jbaumann/attiny_daemon/hardware/breadboard/Breadboard.JPG

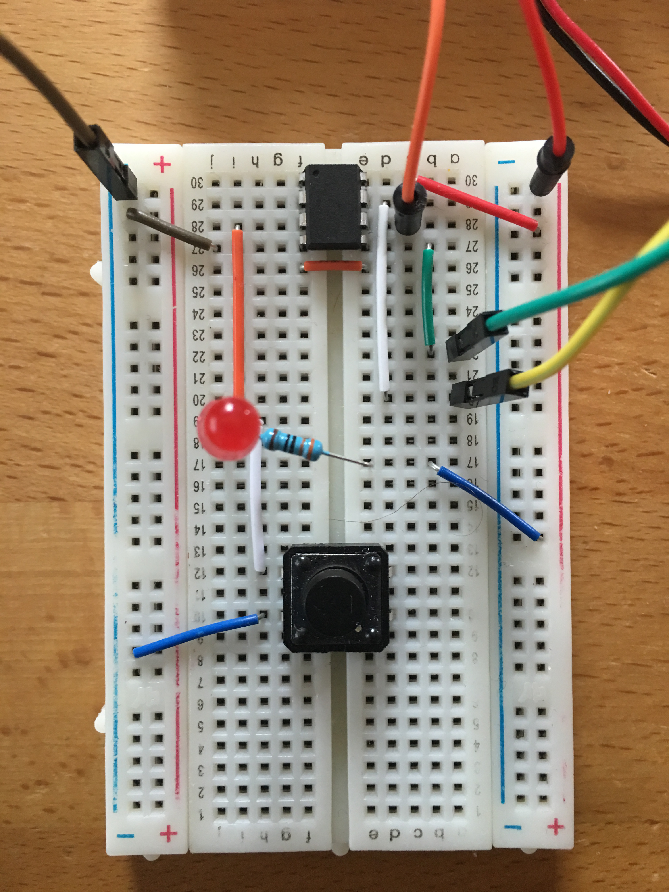
hardware/breadboard/Breadboard.JPG
