jbaumann/attiny_daemon/hardware/breadboard/Breadboard_Raspberry.JPG

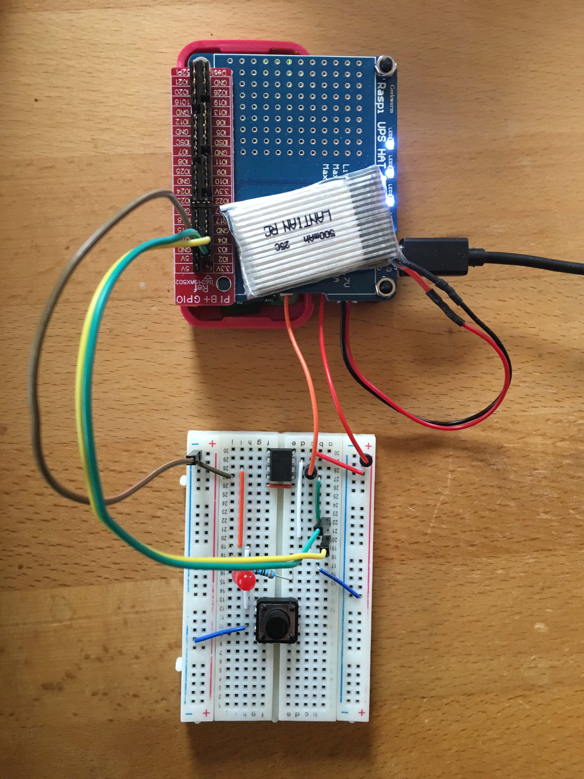
hardware/breadboard/Breadboard_Raspberry.JPG
