jbaumann/attiny_daemon/hardware/v1.8/PCB.png

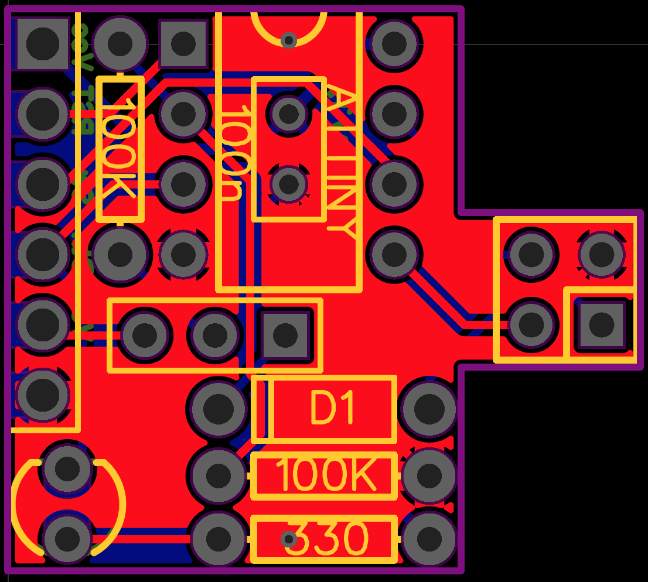
hardware/v1.8/PCB.png
