jbaumann/attiny_daemon/hardware/v1.8/Photo_Bottom_View.png

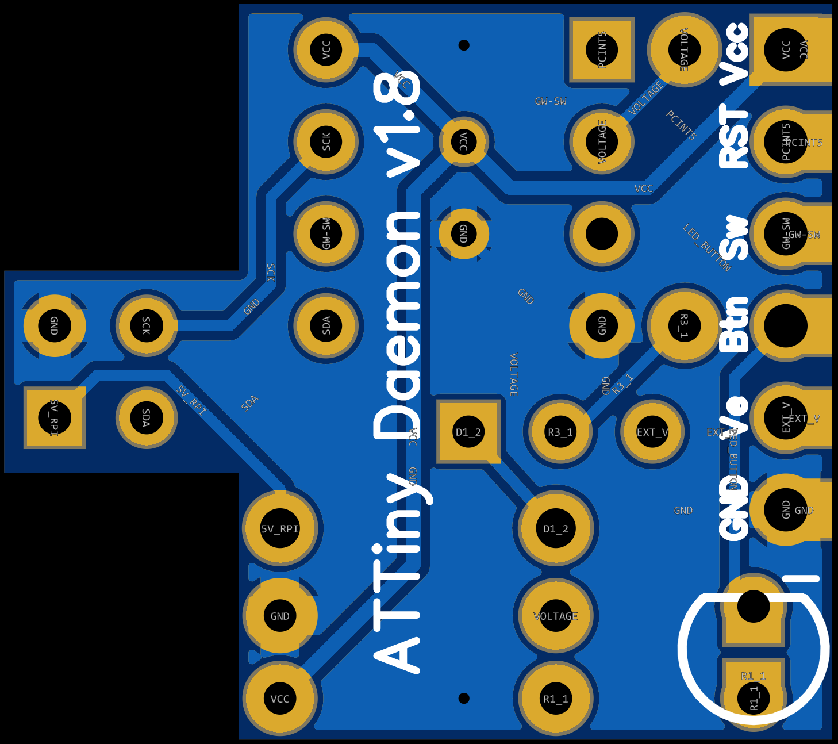
hardware/v1.8/Photo_Bottom_View.png
