jbaumann/attiny_daemon/hardware/v1.8/Schematic_ATTinyDaemon.png

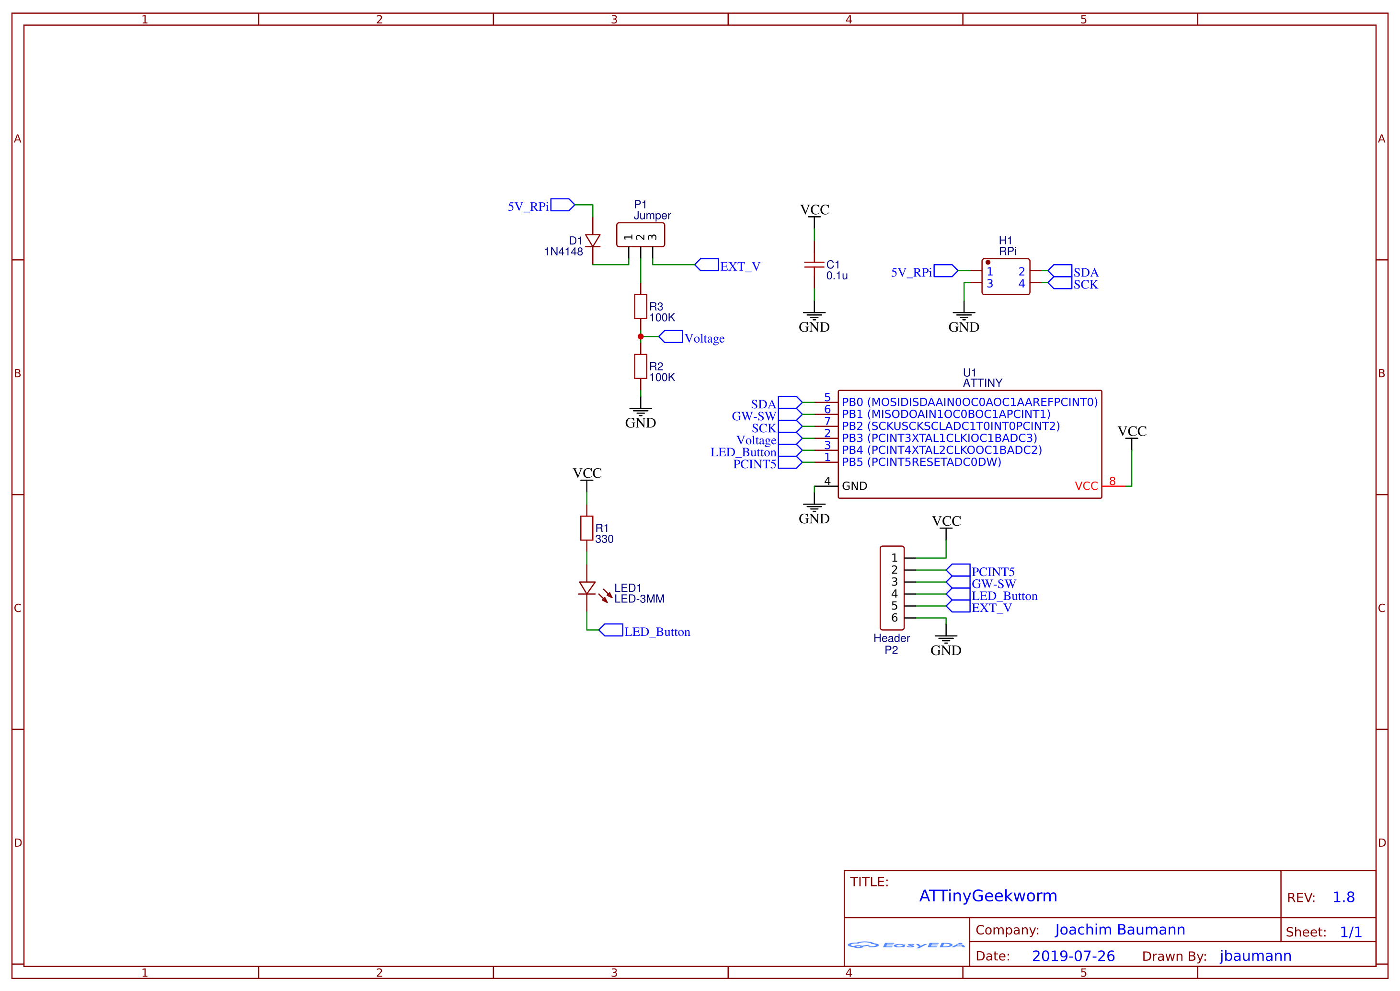
hardware/v1.8/Schematic_ATTinyDaemon.png
