jbaumann/attiny_daemon/hardware/v1.8/Schematic_ATTinyDaemon_cropped.png

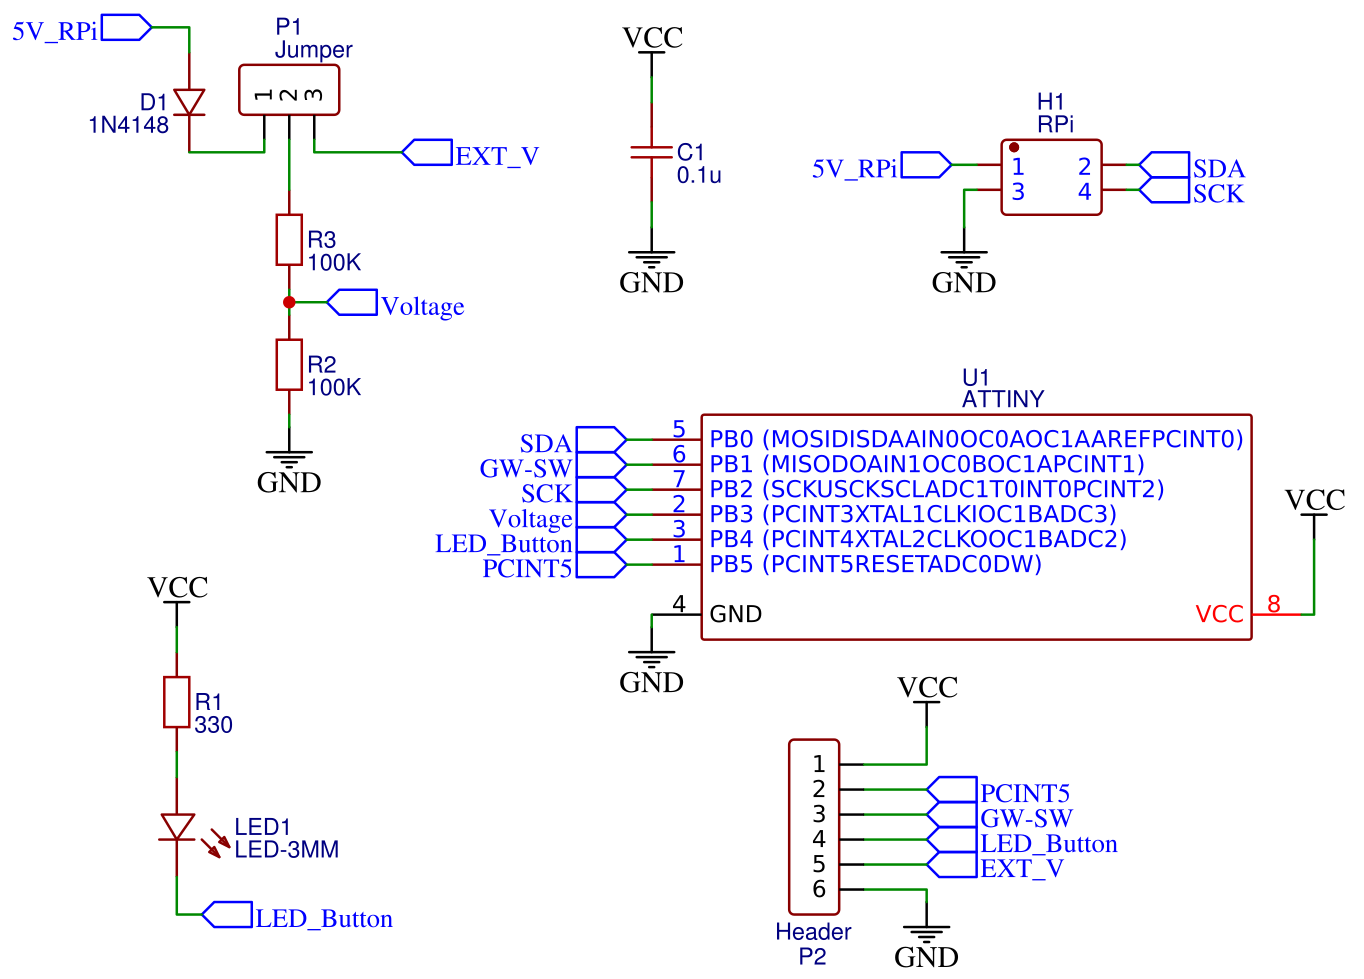
hardware/v1.8/Schematic_ATTinyDaemon_cropped.png
