jbaumann/attiny_daemon/hardware/v1.8shim/PCB.png

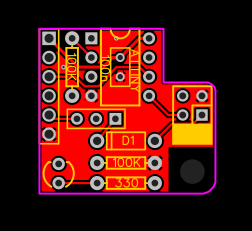
hardware/v1.8shim/PCB.png
