jbaumann/attiny_daemon/hardware/v1.8shim/Photo_Bottom_View.png

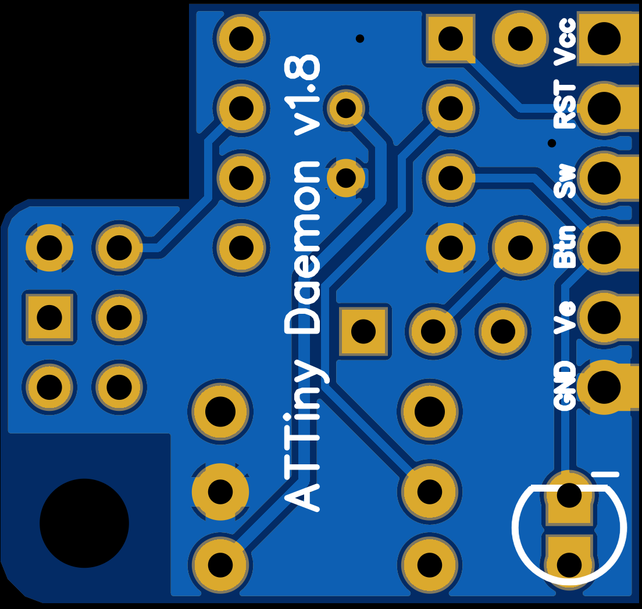
hardware/v1.8shim/Photo_Bottom_View.png
