jbaumann/attiny_daemon/hardware/v1.8shim/ATTiny1.8_installed_on_GW_UPS1.jpeg

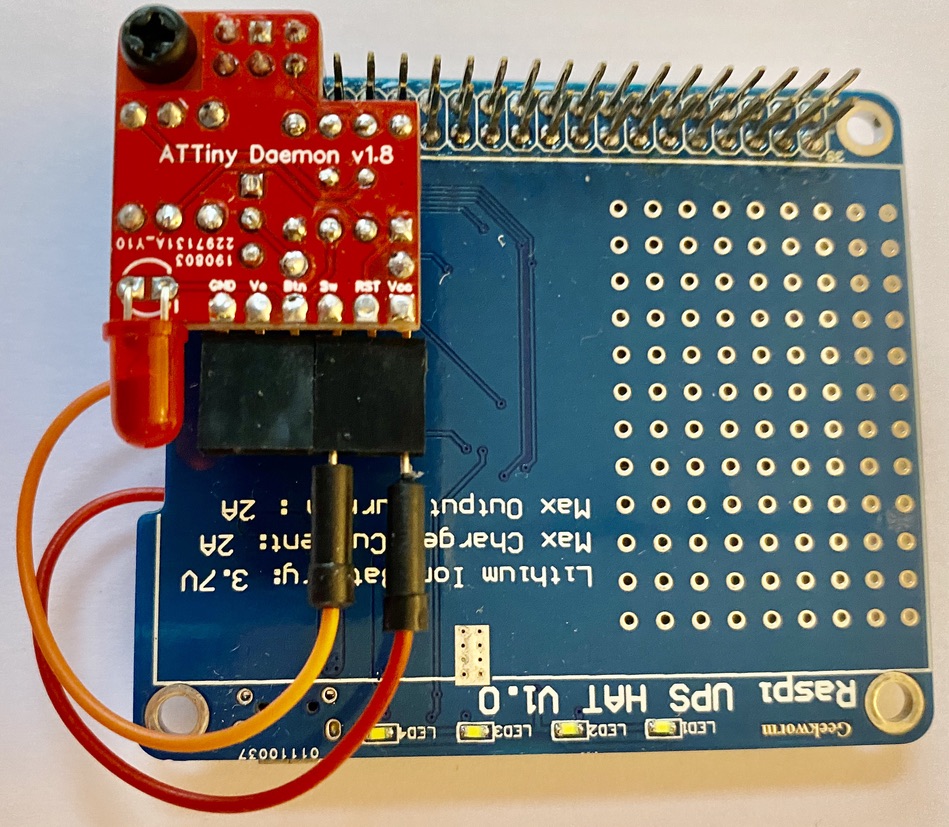
hardware/v1.8shim/ATTiny1.8_installed_on_GW_UPS1.jpeg
