jbaumann/attiny_daemon/(threads)

Thread 1 (2019-08-31):

Multiple-Cell Batteries...

starhawk64, 2019-08-31:
Apologies for contacting you here, but I can find NO other way to get ahold of you (please create or otherwise expose a public-facing email address! It would be very helpful.).

I want to implement this device, using a USB power bank "kit" (a plastic housing and the power bank controller PCB, with room for up to six 18650 cells) and some 18650 cells from old laptop batteries. HOWEVER, I can't tell how to interface / monitor multiple batteries at once, and I'd be concerned about the batteries' respective charges getting out of whack -- I don't know much about LiPoly cells, but I know they have a nasty temper and I know that balancing cells is a concern. (...and, yes, I also know better than to solder to batteries. While I've not read up on the latest LiPoly concerns, I'm mildly experienced as an electronics hobbyist.)

Example listing for power bank kit (mine is identical, but not from that listing) --> https://www.ebay.com/itm/183897827870

jbaumann, 2019-09-03:
Sorry for not exposing the e-mail address, should work now.

To me it seems that the kit is doing all the balancing so that should be taken care of, as far as I can see. However, you would need to connect the Vcc of the ATTiny_Daemon to the balanced output of the batteries inside the power bank. Do you have a schematic of the power bank you want to use?

starhawk64, 2019-09-03:
I don;t need schematics in this case -- it's a "bring your own batteries"
kit. I thought I was more clear about that, sorry...

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

jbaumann, 2019-09-03:
Ok, let us assume that the batteries are balanced by your power bank, for charging and discharging. Then each one of the batteries should have roughly the same charge and thus roughly the same voltage. So simply solder one wire to the positive terminal of the battery holder for one of the batteries and then use that as Vcc for the ATTiny_Daemon (assuming that GND is connected to the negative terminal). Since the current needed by the ATTiny_Daemon is very small compared to the needs of the RPi this shouldn't unbalance the batteries unduly.

starhawk64, 2019-09-03:
OK, great! Thanks :) I'm really looking forward to making this...

One other question... how long can the I2C wires be? What I'm building
requires a short distance there. I was thinking of using optocouplers to
make an I2C-to-current loop adapter (since current loops can go for truly
insane lengths of distance when they have to) but I don't; want to rig that
if I don't have to. I think I can keep it to less than six or eight inches.

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

jbaumann, 2019-09-03:
I'm using normal Dupont wires with 20cm length quite often when experimenting with I2C. This should be around 8in. Since I used a CRC to check the correctness of the transferred data and a simple retransmit in case of errors this should work with even longer cables without problems (I think that 1m is given as a maximum quite often...).

starhawk64, 2019-09-03:
Okay, awesome! Thanks for the help :)

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

jbaumann, 2019-09-05:
Only to be sure: Check that GND and the negative terminal of the battery are connected. Otherwise it is not that simple... And let me know how it goes.

Closed 2020-03-23.

Thread 2 (2019-09-17):

Connections

st599, 2019-09-17:
Hi

I can't see from your documentation where the wires from the modified board are connected to or where exactly the Dupont connector attaches.

Could you provide images of the final layout?

jbaumann, 2019-09-20:
Thank you for the feedback, I will write an additional Wiki entry as soon as I have time.

If you look at the layout from the bottom side, I have labelled the different connections.  Here is a link to the picture: https://github.com/jbaumann/attiny_daemon/blob/master/hardware/v1.8shim/Photo_Bottom_View.png

If you look at this description of the board modification: https://github.com/jbaumann/attiny_daemon/wiki/Modifying-the-Geekworm-UPS-HAT

you connect the red cable (soldered to the battery power) to _Vcc_ (the connection on the right in the picture of the board) and the orange cable (soldered to the switch connection) to the pin labeled _Sw_ (the third from the right on the picture.

If you want to connect a button you simple connect it to Btn and GND, and if you want to measure an additional external voltage you connect it to Ve.

Does this help until I write the documentation?

adrianmihalko, 2019-12-16:
@jbaumann thanks for this great project. I aggree that the Wiki is covering many thing, but it's a little bit unclear to me. There should be a single page with

- modification of the Pi, needed to install the PCB
- complete assembly of the PCB and it's installation on the Pi
- Software installation

Anyone has one or two PCB free available in the EU? If I order now, I need to wait 1 month from china. :(

jbaumann, 2019-12-18:
Adrian, thank you for your praise and your suggestion. I‘m not sure whether a single page with all the information is better than multiple pages, but I can try and write a step-by-step guide that references the other pages that I have already written.

The Pi does not need any modification, which was in fact one of my goals when creating the project. The UPS has to be modified though.
The assembly of the PCB is extremely simple and the silk screen printed on the PCB even gives the values for every component, so this shouldn‘t be a problem, but I‘ll look into writing something up with a few pictures (e.g., components with a low height first, how to bend the connector and the LED etc.).
One question, though, without being disrespectful: If someone is able to follow the instructions to modify the UPS, shouldn‘t they also be able to assemble the board?

The software installation is already described in detail in this page: https://github.com/jbaumann/attiny_daemon/wiki/Installation-on-the-Raspberry-Pi

My experience with JLCPCB (I‘m not affiliated with them in any way) is very good and so far I have received the PCBs I ordered in 2 weeks (more or less). So it is not as bad as you think, but you won‘t be receiving the PCBs before Christmas.

jbaumann, 2020-01-06:
I have now described the assembly of the board in details, please have a look: https://github.com/jbaumann/attiny_daemon/wiki/Assembling-the-ATTiny_Daemon-Hardware

jbaumann, 2020-01-06:
I have described the connections to the board in detail on the following page: https://github.com/jbaumann/attiny_daemon/wiki/Connecting-the-ATTiny_Daemon-Hardware

Please have a look

adrianmihalko, 2020-01-08:
Wow, it's way more clear now. Thanks for the update, parts ordered.

Closed 2020-03-23.

Thread 3 (2019-10-12):

Support for Geekworm's new UPS HAT2?

poky, 2019-10-12:
It appears Geekworm has released their RPi4B supported UPS HAT

https://geekworm.com/products/raspberry-pi-ups-hat-2

It also mentioned the I2C power off function, does anyone on here have tried?

jbaumann, 2019-10-12:
It sounds pretty interesting, and if it works as promised then we might be able to use it with ATTiny_Daemon directly, without the hardware modification.

I haven’t read about an I2C power-off feature, only the auto-power-on. Was it this feature you meant?

I have contacted Geekworm and asked for further information (chips, schematics, etc.). If it sounds ok I will order (at least) one to test it...

jbaumann, 2019-10-12:
And already got an answer. They “cannot” provide any information. I looked at the photo of the UPS2, and I cannot read anything on the chips, but they also have a Github repo for it https://github.com/geekworm-com/UPS2. They use a power-off dtoverlay.

jbaumann, 2019-10-12:
I have been offered a sample to experiment with, looking forward to test it.

akula3, 2019-12-03:
Hello Joachim!
I'm looking for an UPS with the same features like you.
Your project is very interesting, but I wouldn't trust me to solder on SMD's.
Did you make already some positive experience with the UPS HAT2 from geekworm and can share that?
Danke schön :-)

jbaumann, 2019-12-11:
I have now done the first tests and the preliminary conclusion is that it might be usable as an UPS. It will need the ATTinyDaemon to work properly though.
Caveats: The charge amperage should be changed from 2A (default setting) to 1A. To do this a solder bridge has to be removed and another one soldered on two pads. This shouldn't be a problem even for beginners.
I would also enable the additional signalling that the RPi has shut down, and this needs another solder bridge.
Detailed information will follow in a few weeks...

And akula3, you should never try to charge a LiPo battery using a Li-Ion charging circuit.

jbaumann, 2020-03-29:
I just created a new release that supports the Geekworm UPS2. I currently use it successfully and can recommend it. One modification is necessary though. You should change the maximum charge current to 1A, otherwise the output voltage will dip for a short time sometimes leading to crashes. And you really need to use a battery with at least 2.500mAh (to provide the maximum needed amperag).
I will try and find the time to write up a review and how to install everything (much simpler than with the Geekworm UPS 1, you only need to solder a cable to the switch itself and one to the battery pad with the positive voltage).

jbaumann, 2020-04-11:
It took some time to write it up but you can find the short review and the needed modifications in the Wiki.

Closed 2020-04-11.

Thread 4 (2020-02-06):

Help needed

rahmanshaber, 2020-02-06:
Hi, I am developing a portable pi UMPC/sidekick. I want to add your solution there and forget about developing one from ground.
So i need Help of yours to get things right.
1. i will use a existing battery charging breakout board to charge the battery. [this one](https://www.aliexpress.com/item/32798858483.html)
2. so can i use the the ups part form your project to power off the system from raspberry pi and a button to boot the pi?
3. i want to see the battery details in with regular way like you can see the laptop battery details in app like xfce-battery or lxqt-battery plugin for panel . Or a terminal way is ok.

Please help me out
Here is my project.
https://mutantc.gitlab.io/

jbaumann, 2020-02-14:
Hi,

I‘m sorry for the delay in answering your e-Mail. I‘m currently on vacation and will look into it after I‘m back. Without looking into the details most of what you need should be possible. Starting the Pi using abutting might be a bit more complicated but let me think about that when I‘m back.

Cheers, Joachim
Am 6. Feb. 2020, 07:46 +0200 schrieb rahmanshaber <notifications@github.com>:
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

rahmanshaber, 2020-02-16:
thanks. I am waiting.

jbaumann, 2020-03-23:
The button should work as you need it (it was already implemented), and the data can be read using the Python class Attiny_i2c. Its use is shown in the script useATTiny.py. You can use this to display the needed information however you want it.

Closed 2020-03-23.

Thread 5 (2020-02-15):

Couldn't read 16 bit register 0x1 correctly.

BaiGeorgi, 2020-02-15:
When i run "sudo systemctl status attiny_daemon" i get this error:

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

Can you tell me what is wrong?

jbaumann, 2020-02-15:
I‘m currently on vacation, but this means that not all read requests have been successful (which is quite normal and no problem) and that you have the debug flag still enabled in your configuration. As long as you only get the debug message and no warning everything is ok.
If you do not want to see these messages simply turn debug messages off as soon as you have verified that everything works ok.

BaiGeorgi, 2020-02-15:
Thank you for the information.

Closed 2020-02-15.

Thread 7 (2020-02-24):

USIWire issue?

pawsnizzy, 2020-02-24:
Hi,
I am intent on implementing this device on my RPi, but am getting the following errors in the Arduino IDE:

`In file included from C:\Users\Dave\Documents\Arduino\libraries\USIWire\src\USI_TWI_Master/USI_TWI_Master.h:76:0,

                 from C:\Users\Dave\Documents\Arduino\libraries\USIWire\src\USIWire.cpp:27:

C:\Users\Dave\Documents\Arduino\libraries\USIWire\src\USI_TWI_Master/usi_io.h:1:1: error: expected unqualified-id before '.' token

 ../USI_TWI_Slave/usi_io.h

 ^

C:\Users\Dave\Documents\Arduino\libraries\USIWire\src\USIWire.cpp: In member function 'void USIWire::begin()':

C:\Users\Dave\Documents\Arduino\libraries\USIWire\src\USIWire.cpp:55:3: error: 'USI_TWI_Master_Initialise' was not declared in this scope

   USI_TWI_Master_Initialise();

   ^~~~~~~~~~~~~~~~~~~~~~~~~

C:\Users\Dave\Documents\Arduino\libraries\USIWire\src\USIWire.cpp:55:3: note: suggested alternative: 'USI_TWI_Slave_Initialise'

   USI_TWI_Master_Initialise();

   ^~~~~~~~~~~~~~~~~~~~~~~~~

   USI_TWI_Slave_Initialise

Multiple libraries were found for "USIWire.h"
 Used: C:\Users\Dave\Documents\Arduino\libraries\USIWire
Multiple libraries were found for "EEPROM.h"
 Used: C:\Program
exit status 1
Error compiling for board ATtiny25/45/85.
`
Can you suggest where I went wrong - these error messages might as well be in greek:(

Thanks

jbaumann, 2020-02-25:
Hi,

To me this looks like multiple libraries/library versions for the USIWire implementation in your library path. Could you check and verify that you have only one library version (and preferably the one that I used i.e., 0.1.0)?

The same seems to have happened with your eeprom library...

Cheers, Joachim
Am 24. Feb. 2020, 21:25 +0100 schrieb pawsnizzy <notifications@github.com>:
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

pawsnizzy, 2020-03-15:
No multople libaries at all - I've even gone so far as to delete EVERY library except the 2 above - and it's still the same

adrianmihalko, 2020-03-21:
I have same problem. Arduino 1.8.12. Without Usiwire library I get error about missing library (as expected)

```
In file included from /Users/adrianmihalko/Downloads/attiny_daemon-master/firmware/ATTinyDaemon/ATTinyDaemon.ino:1:0:
ATTinyDaemon.h:1:10: fatal error: USIWire.h: No such file or directory
 #include <USIWire.h>
          ^~~~~~~~~~~
compilation terminated.
exit status 1
USIWire.h: No such file or directory
```

Now, I install library as Sketch - Include Library - Add .ZIP Library and I choose USIWire-0.1.0.zip.

I click Very/Compile and I get the same error:

```
In file included from /Users/adrianmihalko/Documents/Arduino/libraries/USIWire-0.1.0/src/USI_TWI_Master/USI_TWI_Master.h:76:0,
                 from /Users/adrianmihalko/Documents/Arduino/libraries/USIWire-0.1.0/src/USIWire.cpp:27:
/Users/adrianmihalko/Documents/Arduino/libraries/USIWire-0.1.0/src/USI_TWI_Master/usi_io.h:1:1: error: expected unqualified-id before '.' token
 ../USI_TWI_Slave/usi_io.h
 ^
/Users/adrianmihalko/Documents/Arduino/libraries/USIWire-0.1.0/src/USIWire.cpp: In member function 'void USIWire::begin()':
/Users/adrianmihalko/Documents/Arduino/libraries/USIWire-0.1.0/src/USIWire.cpp:55:3: error: 'USI_TWI_Master_Initialise' was not declared in this scope
   USI_TWI_Master_Initialise();
   ^~~~~~~~~~~~~~~~~~~~~~~~~
/Users/adrianmihalko/Documents/Arduino/libraries/USIWire-0.1.0/src/USIWire.cpp:55:3: note: suggested alternative: 'USI_TWI_Slave_Initialise'
   USI_TWI_Master_Initialise();
   ^~~~~~~~~~~~~~~~~~~~~~~~~
   USI_TWI_Slave_Initialise
exit status 1
Error compiling for board ATtiny25/45/85.
```

jbaumann, 2020-03-23:
Ok, I'm not sure how this happens, but if you use "Sketch - Include Library - Add .ZIP Library", then the file contains only the following: "../USI_TWI_Slave/usi_io.h". This is clearly wrong and two possible explanations are on the top of my mind:
- The original author uses a symbolic link that is interpreted wrongly by the Arduino IDE when unpacking the files
- The Zip-Archive knows that both files are the same and saves only a reference, which again is interpreted wrongly by the Arduino IDE
In both case I would see the problem in the Arduino IDE.

Two simple possible fixes:
- Copy the file from the TWI_Slave over to the TWI_Master
- Remove the directory, unpack the library manually and copy it to your libraries folder

I suggest the second way as the general way to install libraries. This ensures that everything that goes wrong comes from your own errors.

puuu, 2020-03-24:
Hello, I am the original author of `USIWire`. Please note that I have released version 0.2.0, which no longer contains symbolic links. It is also back in the Arduino Library Manager.

PS: @jbaumann very amazing project! I had something like this in mind when developing USIWire. I will give it a try!

adrianmihalko, 2020-03-24:
Thank you guys, release 0.2.0 solved the issue.

Closed 2020-03-24.

Thread 8 (2020-08-19):

missing Wire.onInterrupt(disable_watchdog) routine, compilation terminated

deHarro, 2020-08-19:
Hi Joachim,

thanks for the elaborated design and DIY explanations for the RasPi UPS HAT!

Sadly I cannot get the firmware for the AtTiny to compile since there is missing code as stated above (Wire.onInterrupt(disable_watchdog)).
How to fix or circumvent this?
Thanks!

Harald

deHarro, 2020-08-19:
Hi Joachim,

I headed over to puuuu and added your [proposed code fragments](https://github.com/puuu/USIWire/issues/13) into my local copy of his USIWire implementation.

For now this resolves my issue, but how is your preferred solution to that?
Thanks!

Harald

jbaumann, 2020-08-19:
Hi Harald,

I have a fork in my repository that adds exactly this needed functionality. See https://github.com/jbaumann/USIWire.

Until my proposal for an extension is accepted the simplest way is to download this repository and unzip it in the library folder.

Cheers, Joachim

deHarro, 2020-08-19:
Hi Joachim,
ok, the usual missing "über den Tellerrand schauen" :)
I concentrated on the UPS stuff and missed the lib, sorry.

I try to implement your daemon with a Digispark module, but I run into issues when compiling for the Digispark:

- error: 'State' is not a class or namespace
- error: 'Register' is not a class or namespace
- error: 'Reset_Configuration::Value' is not a class or namespace

If I choose AtTiny85 as device, all is well.

Any advice on that?
Thanks!

Harald

jbaumann, 2020-08-19:
### Explanation
That one is simple. Every board definition can contain a definition of all the tools that are needed to compile the software for the specific board and hardware. If this is used then it nails down e.g. the version of the compiler used.
Digistump has done this and since the package definition is quite old the compiler used in that definition is quite old as well. The code that I've written uses newer compiler functionality and does not work with very old compiler versions.
### Fix
Depending on the system on which you run the IDE and on your knowledge of the underlying system different ways are possible to solve this. I would suggest one of the following:
1. If your system allows symbolic links and you know that you don't need the old compiler anymore you can substitute the old compiler directory with a link to the newest compiler version.
These directories can be found in `<Arduino Directory>/packages/arduino/tools/avr-gcc`. You can determine the Arduino Directory by looking for the location of the preferences.txt file in the Preference Pane.
2. Edit the package definition. This is named `package_digistump_index.json` and can be found in the Arduino Directory as well.
In the file look for the definition of the "Tool Dependencies" in "Digistump AVR Boards" or simply search for the string "4.8.1-arduino5". Change this to the name of the directory for your newest compiler, in my case "7.3.0-atmel3.6.1-arduino7".

These modifications should be done when the Arduino IDE is not running.

When you restart the Arduino IDE it should use the newest compiler and the next problem will be that the EEPROM-library cannot be found. Simply copy the library from the ATTinyCore definition to the Digistump definition and you should be good to go. The respective directories on my system are
`<Arduino Directory>/packages/ATTinyCore/hardware/avr/1.3.3/libraries`
 and `<Arduino Directory>/packages/digistump/hardware/avr/1.6.7/libraries`.

deHarro, 2020-08-19:
Wow, thanks a lot!
This did the trick.

I normally use Visual Studio with the VisualMicro extension to code for my Arduinos and such, but sometimes I fall back to the IDE.
Will this change be transparent for all other projects I have with Digisparks, or have I to revert to the original setting, when I work on other projects?

Can you please explain, why the deamon code is nailed to 8 MHz? (The Digispark has to run at 16,5 MHz to get the USB connection done (only at program time)).

Thanks!

Harald

jbaumann, 2020-08-20:
My brilliant idea in using the ArduinoIDE was to use something that poses a minimal problem even for beginners. I normally use IDEs that offer a minimum of user support (e.g., Visual Code, Eclipse, Intellij Idea...).

The change I suggested is a general change for all projects with Digisparks. If you are familiar with JSON structures, then simply copy the whole list entry (i.e., the object with the name "Digistump AVR Boards"), give it a new name e.g., "Digistump AVR Boards New Compiler" and change the dependency definition there.

This introduces a new menu with the given name and leaves the rest untouched.

Regarding the clock frequency: The datasheet says on p.163 in figure 21-1 and 21-2, and on  p. 172 in figure 22-2 that 2.7V and 10 MHz go hand in hand. If we want to guarantee that the processor runs without problems even at 3V or below, we cannot go above 8MHz. With 16MHz we would need a stable 4V, and this is simply not sensible with a LI-Ion battery that goes below 3V without damage.

deHarro, 2020-08-21:
That, too, was the idea behind my approach to use a Digispark as controller. If it had beeen feasible to program the controller without a dedicated programming device, that would have made it even easier for others to build your solution.
But the facts you write regarding the clock frequency kills that approch.

I have to confess, I rigged my test board wrong and didn't catch the drawbacks...
I used the 5V output of the HAT to power the Digispark, what runs perfectly well until the HAT is switched off :-)
The next step, switching the HAT back ON after the battery is recharged, wasn't on my mind til now.

Ok, so I have to revert to a standard AtTiny85, or at least remove some superflous parts on the Spark, which prevent it from normal operation, anyways. I.e. the zener diodes on two IOs for the USB stuff interfere with standard IO stuff.

Tonight I had another idea, but before starting to implement it, I better ask...
Why do you use an analog input to get the battery voltage, having I2C and the corresponding chip on the HAT on hands?
Let me guess... if the HAT is switched off, the chip doesn't answer I2C requests. True?

Thanks!
Harald

Closed 2020-08-23.

Thread 9 (2021-01-18):

Q: Replace battery with Super-capacitors?

ankostis, 2021-01-18:
@jbaumann  have you considere altering the design and avoid dependence on another charger circuit,
and rely instead on super-capacotors?
(something along the lines of https://juice4halt.com/)

jbaumann, 2021-01-19:
The ATTiny_Daemon is always depending of some kind of external buffer circuit that provides power for the RPi to shut down safely. This can be a LiIon or LiFePO4 battery with its charging circuit or a super capacitor circuit like the one you mentioned.  It can control this external circuit if possible and shut down and restart the RPi according to the state of that circuit.

One of the newest configuration options is that the ATTiny_Daemon can watch the external voltage and tell the RPi to shut down as soon as that voltage sinks below 4.7V. This would be the configuration option that I would use for that use case.

ankostis, 2021-01-19:
Thank you, you may closer it now.
If anyone has more resources (e.g. schematics), can add them here.

Closed 2021-01-19.

Thread 10 (2021-11-17):

Attiny85 correct board in ArduinoIDE

adrianmihalko, 2021-11-17:
Dear Joachim,

Which is the correct board version for us? In the Wiki you mention only Attiny 25/45/85, but there are multiple options. The most obvious is Attiny 25/45/85 but it is No bootloader version and we upload bootloader in the next step. I am a little bit confused here.

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

jbaumann, 2021-11-17:
Hi Adrian,

it is the version without the bootloader, because we use the whole available space for the firmware.

Cheers, Joachim

adrianmihalko, 2021-11-17:
Thank you very much. :)

adrianmihalko, 2021-11-17:
Let me ask you one more question. I put everything together and tested based on the guide.

I changed config:

```
button function = shutdown
ups configuration = 0x0
primed = true
```

ups configuration is 0x0 because I have Geekworm 1.0 board. Primed set to true after I checked I am getting data with ./showStateAndBattery.py. After that I restarted to make changes active.

I started by unplugging the power source, after 4 hour finally battery was empty enough to see if Attiny Daemon is working or not:

https://www.youtube.com/watch?v=QkljELmsSIg

As you can see for some it tries to boot at certain intervals. This is how it supposed to work? Isn't this bad for SD card? I thought it would be completely stay off after empty battery shutdown and reamins in this state until Attiny sense voltage.

After connecting to power source:

```
$ ./showStateAndBattery.py
INFO:root:Current state is 0x20: SHUTDOWN_STATE
INFO:root:Current should_shutdown value is 0x0
INFO:root:Current battery voltage is 3.839V.
INFO:root:Current external voltage is 5.566V.
INFO:root:Current warn voltage is 3.4V.
INFO:root:Current ups shutdown voltage is 3.2V.
INFO:root:Current restart voltage is 3.9V.
pi@octopi:/opt/attiny_daemon $ ./showStateAndBattery.py
INFO:root:Current state is 0x20: SHUTDOWN_STATE
INFO:root:Current should_shutdown value is 0x0
INFO:root:Current battery voltage is 3.881V.
INFO:root:Current external voltage is 5.594V.
INFO:root:Current warn voltage is 3.4V.
INFO:root:Current ups shutdown voltage is 3.2V.
INFO:root:Current restart voltage is 3.9V.
pi@octopi:/opt/attiny_daemon $ ./showStateAndBattery.py
INFO:root:Current state is 0x0: RUNNING_STATE
INFO:root:Current should_shutdown value is 0x0
INFO:root:Current battery voltage is 4.078V.
INFO:root:Current external voltage is 5.612V.
INFO:root:Current warn voltage is 3.4V.
INFO:root:Current ups shutdown voltage is 3.2V.
INFO:root:Current restart voltage is 3.9V.
```

jbaumann, 2021-11-17:
First of all, this behaviour is very bad for the SD card (or any storage medium). You should remove the orange cable (which is used to turn the UPS off and on) and then make further tests.

First observation: Controlling the UPS works.

Second observation: I assume that the output has been done after you restarted the RPi, while the UPS was still charging the battery. This shows, that the state machine works as intended.

The video however, shows that the ATTiny tries to restart the RPi after a very short time. This could come from a timeout that is way too short. Could you post your full config file? After having run the daemon the config file should contain all relevant data.

And what is the output of the running attiny_daemon service?

I think you are 90% there and it might be only a little thing, but be careful not to stress your storage too much.

jbaumann, 2021-11-17:
The undervoltage is the result of the input voltage dropping below 4.65V. Since the UPS provides the input voltage, it could be a problem of the UPS trying to charge the battery at the same time as trying to feed the power to the RPi. The first UPS has the problem that it can provide only a limited amperage and thus might not be the right choice for a RPi3. If you are using the RPi without any USB devices you might get away with it, since the RPi itself uses 3.3V for nearly everything. What kind of power source are you using?

adrianmihalko, 2021-11-17:
> attiny_daemon

I haven't checked yet, but there are some interesting errors:

```
pi@octopi:/opt/attiny_daemon $ journalctl -r -u attiny_daemon
-- Logs begin at Wed 2021-11-17 18:17:01 CET, end at Wed 2021-11-17 20:15:21 CET. --
Nov 17 20:15:21 octopi attiny_daemon.py[345]: Sleeping for 20 seconds.
Nov 17 20:15:00 octopi attiny_daemon.py[345]: Sleeping for 20 seconds.
Nov 17 20:14:39 octopi attiny_daemon.py[345]: Sleeping for 20 seconds.
Nov 17 20:14:17 octopi attiny_daemon.py[345]: Sleeping for 20 seconds.
Nov 17 20:13:56 octopi attiny_daemon.py[345]: Sleeping for 20 seconds.
Nov 17 20:13:35 octopi attiny_daemon.py[345]: Sleeping for 20 seconds.
Nov 17 20:13:14 octopi attiny_daemon.py[345]: Sleeping for 20 seconds.
Nov 17 20:12:53 octopi attiny_daemon.py[345]: Sleeping for 20 seconds.
Nov 17 20:12:53 octopi sudo[948]: pam_unix(sudo:auth): auth could not identify password for [pi]
Nov 17 20:12:53 octopi sudo[948]: pam_unix(sudo:auth): conversation failed
Nov 17 20:12:53 octopi attiny_daemon.py[345]: sudo: no tty present and no askpass program specified
Nov 17 20:12:53 octopi attiny_daemon.py[345]: shutting down now...
Nov 17 20:12:47 octopi attiny_daemon.py[345]: Unknown shutdown_level 130. Shutting down.
Nov 17 20:12:26 octopi attiny_daemon.py[345]: Sleeping for 20 seconds.
Nov 17 20:12:26 octopi sudo[934]: pam_unix(sudo:auth): auth could not identify password for [pi]
Nov 17 20:12:26 octopi sudo[934]: pam_unix(sudo:auth): conversation failed
Nov 17 20:12:26 octopi attiny_daemon.py[345]: sudo: no tty present and no askpass program specified
Nov 17 20:12:26 octopi attiny_daemon.py[345]: shutting down now...
Nov 17 20:12:26 octopi attiny_daemon.py[345]: Couldn't set 8 bit register after 9 retries.
Nov 17 20:12:06 octopi attiny_daemon.py[345]: Unknown shutdown_level 130. Shutting down.
Nov 17 20:11:45 octopi attiny_daemon.py[345]: Sleeping for 20 seconds.
Nov 17 20:11:45 octopi sudo[915]: pam_unix(sudo:auth): auth could not identify password for [pi]
Nov 17 20:11:45 octopi sudo[915]: pam_unix(sudo:auth): conversation failed
Nov 17 20:11:45 octopi attiny_daemon.py[345]: sudo: no tty present and no askpass program specified
Nov 17 20:11:45 octopi attiny_daemon.py[345]: shutting down now...
Nov 17 20:11:45 octopi attiny_daemon.py[345]: Couldn't set 8 bit register after 9 retries.
Nov 17 20:11:25 octopi attiny_daemon.py[345]: Unknown shutdown_level 130. Shutting down.
Nov 17 20:11:04 octopi attiny_daemon.py[345]: Sleeping for 20 seconds.
Nov 17 20:11:04 octopi attiny_daemon.py[345]: sudo: no tty present and no askpass program specified
Nov 17 20:11:04 octopi attiny_daemon.py[345]: shutting down now...
Nov 17 20:11:04 octopi attiny_daemon.py[345]: Couldn't set 8 bit register after 9 retries.
Nov 17 18:17:31 octopi attiny_daemon.py[345]: Battery is at warn level. Shutting down.
Nov 17 18:17:30 octopi attiny_daemon.py[345]: Merging completed
Nov 17 18:17:25 octopi attiny_daemon.py[345]: Couldn't read 16 bit register 0x14 correctly.
Nov 17 18:17:10 octopi attiny_daemon.py[345]: Merge Values and save if necessary
Nov 17 18:17:10 octopi attiny_daemon.py[345]: ATTiny firmware version 2.13.14
```

With an empty battery after 2 minute of boot:

```
pi@octopi:/opt/attiny_daemon $ date
Wed Nov 17 20:12:35 CET 2021
pi@octopi:/opt/attiny_daemon $ ./showStateAndBattery.py
INFO:root:Current state is 0x20: SHUTDOWN_STATE
INFO:root:Current should_shutdown value is 0x82
INFO:root:Current battery voltage is 3.81V.
INFO:root:Current external voltage is 5.57V.
INFO:root:Current warn voltage is 3.4V.
INFO:root:Current ups shutdown voltage is 3.2V.
INFO:root:Current restart voltage is 3.9V.
pi@octopi:/opt/attiny_daemon $ date
Wed Nov 17 20:13:57 CET 2021
pi@octopi:/opt/attiny_daemon $ ./showStateAndBattery.py
INFO:root:Current state is 0x0: RUNNING_STATE
INFO:root:Current should_shutdown value is 0x2
INFO:root:Current battery voltage is 3.957V.
INFO:root:Current external voltage is 5.572V.
INFO:root:Current warn voltage is 3.4V.
INFO:root:Current ups shutdown voltage is 3.2V.
INFO:root:Current restart voltage is 3.9V.
pi@octopi:/opt/attiny_daemon $ date
Wed Nov 17 20:18:12 CET 2021
pi@octopi:/opt/attiny_daemon $ ./showStateAndBattery.py
INFO:root:Current state is 0x0: RUNNING_STATE
INFO:root:Current should_shutdown value is 0x2
INFO:root:Current battery voltage is 4.115V.
INFO:root:Current external voltage is 5.582V.
INFO:root:Current warn voltage is 3.4V.
INFO:root:Current ups shutdown voltage is 3.2V.
INFO:root:Current restart voltage is 3.9V.
```

One more shutdown test with the Orange (switch) cable removed:

```
Nov 17 20:32:30 octopi attiny_daemon.py[345]: Sleeping for 20 seconds.
Nov 17 20:32:51 octopi attiny_daemon.py[345]: Sleeping for 20 seconds.

Nov 17 20:33:12 octopi attiny_daemon.py[345]: Battery is at warn level. Shutting down.   (I measured 3.3V at VCC+GND with my multimeter)

Nov 17 20:33:32 octopi attiny_daemon.py[345]: Couldn't set 8 bit register after 9 retries.
Nov 17 20:33:32 octopi attiny_daemon.py[345]: shutting down now...
Nov 17 20:33:32 octopi attiny_daemon.py[345]: sudo: no tty present and no askpass program specified
Nov 17 20:33:32 octopi sudo[1400]: pam_unix(sudo:auth): conversation failed
Nov 17 20:33:32 octopi sudo[1400]: pam_unix(sudo:auth): auth could not identify password for [pi]
Nov 17 20:33:32 octopi attiny_daemon.py[345]: Sleeping for 20 seconds.
Nov 17 20:33:54 octopi attiny_daemon.py[345]: Unknown shutdown_level 130. Shutting down.
Nov 17 20:34:14 octopi attiny_daemon.py[345]: Couldn't set 8 bit register after 9 retries.
Nov 17 20:34:14 octopi attiny_daemon.py[345]: shutting down now...
Nov 17 20:34:14 octopi attiny_daemon.py[345]: sudo: no tty present and no askpass program specified
Nov 17 20:34:14 octopi sudo[1413]: pam_unix(sudo:auth): conversation failed
Nov 17 20:34:14 octopi sudo[1413]: pam_unix(sudo:auth): auth could not identify password for [pi]
Nov 17 20:34:14 octopi attiny_daemon.py[345]: Sleeping for 20 seconds.
Nov 17 20:34:35 octopi attiny_daemon.py[345]: Unknown shutdown_level 130. Shutting down.
Nov 17 20:34:55 octopi attiny_daemon.py[345]: Couldn't set 8 bit register after 9 retries.
Nov 17 20:34:55 octopi attiny_daemon.py[345]: shutting down now...
Nov 17 20:34:55 octopi attiny_daemon.py[345]: sudo: no tty present and no askpass program specified
Nov 17 20:34:55 octopi sudo[1427]: pam_unix(sudo:auth): conversation failed
Nov 17 20:34:55 octopi sudo[1427]: pam_unix(sudo:auth): auth could not identify password for [pi]
Nov 17 20:34:55 octopi attiny_daemon.py[345]: Sleeping for 20 seconds.
Nov 17 20:35:16 octopi attiny_daemon.py[345]: Unknown shutdown_level 130. Shutting down.
Nov 17 20:35:36 octopi attiny_daemon.py[345]: Couldn't set 8 bit register after 9 retries.
Nov 17 20:35:36 octopi attiny_daemon.py[345]: shutting down now...
Nov 17 20:35:36 octopi attiny_daemon.py[345]: sudo: no tty present and no askpass program specified
Nov 17 20:35:36 octopi sudo[1445]: pam_unix(sudo:auth): conversation failed
Nov 17 20:35:36 octopi sudo[1445]: pam_unix(sudo:auth): auth could not identify password for [pi]
Nov 17 20:35:36 octopi attiny_daemon.py[345]: Sleeping for 20 seconds.
```

One more test with Orange cable attached. Empty battery charged for 5 minutes then test:

```
pi@octopi:/opt/attiny_daemon $ journalctl -u attiny_daemon -f
-- Logs begin at Wed 2021-11-17 18:17:01 CET. --
Nov 17 20:36:58 octopi sudo[1480]: pam_unix(sudo:auth): auth could not identify password for [pi]
Nov 17 20:36:58 octopi attiny_daemon.py[345]: Sleeping for 20 seconds.
Nov 17 20:37:19 octopi attiny_daemon.py[345]: Unknown shutdown_level 130. Shutting down.
Nov 17 20:37:37 octopi attiny_daemon.py[345]: shutting down now...
Nov 17 20:37:37 octopi attiny_daemon.py[345]: sudo: no tty present and no askpass program specified
Nov 17 20:37:37 octopi sudo[1497]: pam_unix(sudo:auth): conversation failed
Nov 17 20:37:37 octopi sudo[1497]: pam_unix(sudo:auth): auth could not identify password for [pi]
Nov 17 20:37:37 octopi attiny_daemon.py[345]: Sleeping for 20 seconds.
Nov 17 20:37:58 octopi attiny_daemon.py[345]: Sleeping for 20 seconds.
Nov 17 20:38:19 octopi attiny_daemon.py[345]: Sleeping for 20 seconds.
Nov 17 20:38:40 octopi attiny_daemon.py[345]: Sleeping for 20 seconds.
Nov 17 20:39:01 octopi attiny_daemon.py[345]: Sleeping for 20 seconds.
Nov 17 20:39:22 octopi attiny_daemon.py[345]: Sleeping for 20 seconds.
Nov 17 20:39:43 octopi attiny_daemon.py[345]: Sleeping for 20 seconds.
Nov 17 20:40:04 octopi attiny_daemon.py[345]: Unknown shutdown_level 130. Shutting down.
Nov 17 20:40:24 octopi attiny_daemon.py[345]: Couldn't set 8 bit register after 9 retries.
Nov 17 20:40:24 octopi attiny_daemon.py[345]: shutting down now...
Nov 17 20:40:24 octopi attiny_daemon.py[345]: sudo: no tty present and no askpass program specified
Nov 17 20:40:24 octopi sudo[1549]: pam_unix(sudo:auth): conversation failed
Nov 17 20:40:24 octopi sudo[1549]: pam_unix(sudo:auth): auth could not identify password for [pi]
Nov 17 20:40:24 octopi attiny_daemon.py[345]: Sleeping for 20 seconds.
Nov 17 20:40:45 octopi attiny_daemon.py[345]: Unknown shutdown_level 130. Shutting down.
Nov 17 20:41:05 octopi attiny_daemon.py[345]: Couldn't set 8 bit register after 9 retries.
Nov 17 20:41:05 octopi attiny_daemon.py[345]: shutting down now...
Nov 17 20:41:05 octopi attiny_daemon.py[345]: sudo: no tty present and no askpass program specified
Nov 17 20:41:05 octopi sudo[1569]: pam_unix(sudo:auth): conversation failed
Nov 17 20:41:05 octopi sudo[1569]: pam_unix(sudo:auth): auth could not identify password for [pi]
Nov 17 20:41:05 octopi attiny_daemon.py[345]: Sleeping for 20 seconds.
Nov 17 20:41:26 octopi attiny_daemon.py[345]: Unknown shutdown_level 130. Shutting down.
Nov 17 20:41:46 octopi attiny_daemon.py[345]: Couldn't set 8 bit register after 9 retries.
Nov 17 20:41:46 octopi attiny_daemon.py[345]: shutting down now...
Nov 17 20:41:47 octopi attiny_daemon.py[345]: sudo: no tty present and no askpass program specified
Nov 17 20:41:47 octopi sudo[1585]: pam_unix(sudo:auth): conversation failed
Nov 17 20:41:47 octopi sudo[1585]: pam_unix(sudo:auth): auth could not identify password for [pi]
Nov 17 20:41:47 octopi attiny_daemon.py[345]: Sleeping for 20 seconds.
Nov 17 20:42:08 octopi attiny_daemon.py[345]: Unknown shutdown_level 130. Shutting down.
Nov 17 20:42:28 octopi attiny_daemon.py[345]: Couldn't set 8 bit register after 9 retries.
Nov 17 20:42:28 octopi attiny_daemon.py[345]: shutting down now...
Nov 17 20:42:28 octopi attiny_daemon.py[345]: sudo: no tty present and no askpass program specified
Nov 17 20:42:28 octopi sudo[1601]: pam_unix(sudo:auth): conversation failed
Nov 17 20:42:28 octopi sudo[1601]: pam_unix(sudo:auth): auth could not identify password for [pi]
Nov 17 20:42:28 octopi attiny_daemon.py[345]: Sleeping for 20 seconds.
Nov 17 20:42:49 octopi attiny_daemon.py[345]: Unknown shutdown_level 130. Shutting down.
Nov 17 20:43:09 octopi attiny_daemon.py[345]: Couldn't set 8 bit register after 9 retries.
Nov 17 20:43:09 octopi attiny_daemon.py[345]: shutting down now...
Nov 17 20:43:09 octopi attiny_daemon.py[345]: sudo: no tty present and no askpass program specified
Nov 17 20:43:09 octopi sudo[1617]: pam_unix(sudo:auth): conversation failed
Nov 17 20:43:09 octopi sudo[1617]: pam_unix(sudo:auth): auth could not identify password for [pi]
Nov 17 20:43:09 octopi attiny_daemon.py[345]: Sleeping for 20 seconds.
Nov 17 20:43:30 octopi attiny_daemon.py[345]: Unknown shutdown_level 130. Shutting down.
Nov 17 20:43:50 octopi attiny_daemon.py[345]: Couldn't set 8 bit register after 9 retries.
Nov 17 20:43:50 octopi attiny_daemon.py[345]: shutting down now...
Nov 17 20:43:50 octopi attiny_daemon.py[345]: sudo: no tty present and no askpass program specified
Nov 17 20:43:50 octopi sudo[1632]: pam_unix(sudo:auth): conversation failed
Nov 17 20:43:50 octopi sudo[1632]: pam_unix(sudo:auth): auth could not identify password for [pi]
Nov 17 20:43:50 octopi attiny_daemon.py[345]: Sleeping for 20 seconds.
Nov 17 20:44:11 octopi attiny_daemon.py[345]: Unknown shutdown_level 130. Shutting down.
Nov 17 20:44:31 octopi attiny_daemon.py[345]: Couldn't set 8 bit register after 9 retries.
Nov 17 20:44:31 octopi attiny_daemon.py[345]: shutting down now...
Nov 17 20:44:31 octopi attiny_daemon.py[345]: sudo: no tty present and no askpass program specified
Nov 17 20:44:31 octopi sudo[1645]: pam_unix(sudo:auth): conversation failed
Nov 17 20:44:31 octopi sudo[1645]: pam_unix(sudo:auth): auth could not identify password for [pi]
Nov 17 20:44:31 octopi attiny_daemon.py[345]: Sleeping for 20 seconds.
hard shutdown here by battery @2.6V
```

Shutdown was not performed by software, but I think by battery protection (shutdown was at 2.6-2.7V).

After hard shutdown by battery I measured 0.5V then after for a few seconds  2.7-2.8V, where Pi starts to boot, but battery protection (I think) again shut down the power.

What do you think about this theory?

Observation:

- shutdown is not working by daemon (Unknown shutdown_level 130. Shutting down. + sudo errors in the log?)
- weird: couldn't set registers?

Config:
```

[attinydaemon]
button function = shutdown
ups configuration = 0x0
primed = true
external voltage constant = 700
external voltage coefficient = 2000
sleeptime = 20
ups shutdown voltage = 3200
timeout = 120
pulse length = 4000
pulse length on = 500
pulse length off = 4000
temperature coefficient = 1000
i2c address = 0x37
battery voltage constant = 0
restart voltage = 3900
warn voltage = 3400
temperature constant = -270
battery voltage coefficient = 1000
force shutdown = 0
switch recovery delay = 1000
loglevel = DEBUG
led off mode = 0

adrianmihalko, 2021-11-17:
Progress:

Removed sudo from attiny_daemon.py from there:

```
_shutdown_cmd = "systemctl poweroff"  # sudo allows us to start as user 'pi'
_reboot_cmd  = "systemctl reboot"     # sudo allows us to start as user 'pi'
```

in attiny_daemon.service I changed User=pi to User=root.

Now shutdown works perfectly:

```
pi@octopi:/opt/attiny_daemon $ journalctl -f -u attiny_daemon
-- Logs begin at Wed 2021-11-17 22:03:16 CET. --
Nov 17 22:03:22 octopi systemd[1]: Started ATTiny UPS Daemon.
Nov 17 22:03:23 octopi attiny_daemon.py[347]: config variables are set
Nov 17 22:03:23 octopi attiny_daemon.py[347]: ATTiny Daemon version 2.13.1
Nov 17 22:03:25 octopi attiny_daemon.py[347]: ATTiny firmware version 2.13.14
Nov 17 22:03:25 octopi attiny_daemon.py[347]: Merge Values and save if necessary
Nov 17 22:03:44 octopi attiny_daemon.py[347]: Merging completed
Nov 17 22:03:45 octopi attiny_daemon.py[347]: Sleeping for 20 seconds.
Nov 17 22:04:19 octopi attiny_daemon.py[347]: Sleeping for 20 seconds.
Nov 17 22:04:40 octopi attiny_daemon.py[347]: Sleeping for 20 seconds.
Nov 17 22:05:01 octopi attiny_daemon.py[347]: Sleeping for 20 seconds.
Nov 17 22:05:22 octopi attiny_daemon.py[347]: Sleeping for 20 seconds.
Nov 17 22:05:43 octopi attiny_daemon.py[347]: Sleeping for 20 seconds.
Nov 17 22:06:04 octopi attiny_daemon.py[347]: Sleeping for 20 seconds.
Nov 17 22:06:25 octopi attiny_daemon.py[347]: Sleeping for 20 seconds.
Nov 17 22:06:46 octopi attiny_daemon.py[347]: Unknown shutdown_level 130. Shutting down.
Connection to octopi.local closed by remote host.
Connection to octopi.local closed.
```

I still don't know what is the unknown shutdown_level, but at least it is working now.

At 3.94V (measured with DMM) it started automatically.

can you tell me if this is how supposed to look like when it is off:

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

- UPS green led ON
- Pi power red led ON
- Attiny communication led blinking every 1s
- Charge indicator led is ON

Undervoltage:

[Wed Nov 17 22:14:26 2021] Under-voltage detected! (0x00050005)
[Wed Nov 17 22:14:43 2021] Voltage normalised (0x00000000)
[Wed Nov 17 22:14:51 2021] Under-voltage detected! (0x00050005)
[Wed Nov 17 22:14:55 2021] Voltage normalised (0x00000000)
[Wed Nov 17 22:21:03 2021] Under-voltage detected! (0x00050005)
[Wed Nov 17 22:21:08 2021] Voltage normalised (0x00000000)

Nothing is connected at this time. Charger is an Anker 2 or 2.5Ah? I think I get this warning when it is charges the battery. Battery charging + powering Pi at the same time is maybe too much for this charger.

jbaumann, 2021-11-18:
Which version of Raspbian are you using? I have never had the problem of having to provide a password for sudo from the user pi. I would have to look into that. Running a service as user root is generally a "bad idea"(TM) but in this case, until we have fixed this small problem, it is the right way to go.

The shutdown level is 0x80 + 0x2, which is "battery voltage low" and "RPI initiated shutdown". This should never be read together, because the RPi normally shuts the system down and then this value gets reset. In your case shutting down fails and thus this value is read, but correctly identified as a value indicating a necessary shutdown. I simply have to add a message that states the correct reason (never thought of this...).

The read error directly after the shutdown message looks a bit strange, I'll look into it. But this isn't something to worry about, because the communication is reset on both sides after half the timeout and thus re-established.

The state of the system when off is correct with your configuration. You can set "force shutdown = 1" to tell the ATTiny that it should turn off the UPS as soon as the shutdown voltage has been reached.

jbaumann, 2021-11-19:
Could you check whether you have a file /etc/sudoers.d/010_pi-nopasswd ?

Here on my system:
```
pi@kodi:/etc $ cd sudoers.d/
pi@kodi:/etc/sudoers.d $ dir
010_at-export  010_pi-nopasswd	010_proxy  pihole  README
pi@kodi:/etc/sudoers.d $ sudo cat 010_pi-nopasswd
pi ALL=(ALL) NOPASSWD: ALL
pi@kodi:/etc/sudoers.d $
```
This is the default configuration on Raspbian.

adrianmihalko, 2021-11-19:
Mine seem to be commented out:

```
pi@octopi:/etc/sudoers.d $ ls
010_at-export  010_pi-nopasswd  010_proxy  README  octoprint-service  octoprint-shutdown
pi@octopi:/etc/sudoers.d $ sudo cat 010_pi-nopasswd
[sudo] password for pi:
#pi ALL=(ALL) NOPASSWD: ALL
```

I remembered that I have not a raw Raspbian, but instead Octopi (which is based on Raspbian). So I started to search and what I found? A ticket opened by me https://github.com/guysoft/OctoPi/issues/549 about same issue.

Let's close this issue then. Otherwise now everything works as it should:

```
Nov 19 16:21:19 octopi attiny_daemon.py[354]: Sleeping for 20 seconds.
Nov 19 16:20:58 octopi attiny_daemon.py[354]: Sleeping for 20 seconds.
Nov 19 16:20:57 octopi attiny_daemon.py[354]: Couldn't read register 0x23 correctly: 0x7f
Nov 19 16:20:36 octopi attiny_daemon.py[354]: Sleeping for 20 seconds.
Nov 19 16:20:15 octopi attiny_daemon.py[354]: Sleeping for 20 seconds.
Nov 19 16:19:54 octopi attiny_daemon.py[354]: Sleeping for 20 seconds.
Nov 19 16:19:33 octopi attiny_daemon.py[354]: Sleeping for 20 seconds.
Nov 19 16:19:12 octopi attiny_daemon.py[354]: Sleeping for 20 seconds
```

jbaumann, 2021-11-19:
Fantastic. Good to hear.

adrianmihalko, 2021-11-24:
One more question, button function is set to shutdown, but it doesn't work for some reason. If I press I see green activity LED is blinking, but the system does nothing. Nothing is in the logs.

jbaumann, 2021-11-25:
I assume that the daemon is running as a service. Could you use the script ‘showStateAndBattery.py’ to print out the state and shutdown value before and after a button press? Normally the pressed button is acknowledged on the ATTiny side with the LED blinking, and this information is transferred to the RPi with the next communication between daemon and ATTiny. This directly leads to a log entry that the button has been pressed and that the configured action will be executed. So, even if you have no action configured, the log still shows that the button has been pressed.

Cheers, Joachim
Am 24. Nov. 2021, 19:10 +0100 schrieb adrianmihalko ***@***.***>:
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

adrianmihalko, 2022-09-09:
Hi @jbaumann. I am building another UPS. Which UPS board are you currently recommend? I see you mention Geekworm's UPS3 on index page, but there is no installation guide for that?

jbaumann, 2022-09-10:
Hi @adrianmihalko,

sorry, I never got around to add pictures for the UPS3. It is so simple that I wouldn’t call it a modification. You need the battery power, which you get from the two battery power pads (+ and -) adjacent to the battery connector. Then you need the connection to the switch, which is exposed on an unpopulated header named “sw”. And that’s it. In fact, I’m still using the UPS3 in some of my installations.

Regarding the GeekPi UPS: I never bought a newer version of this UPS, so I cannot say anything new.

I’ve mainly worked on the SuperPower project, where we created a UPS from scratch. Sadly, even though the firmware has been finished, the hardware had some problems, and the second revision has never been finished.

But @Burgduino is currently developing a UPS that will have everything needed and is programmed by me. So, depending on the urgency of your new project you could wait for that…

adrianmihalko, 2022-09-14:
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
Thanks for the detailed info.

>
> But @Burgduino is currently developing a UPS that will have everything needed and is programmed by me. So, depending on the urgency of your new project you could wait for that…

I am sad because of the SuperPower project, it was very promising.

Where I can read more about @Burgduino's project? It is public?

jbaumann, 2022-09-14:
Hi @adrianmihalko, here is the link to his Discord server where he discusses the current status for many of his projects: https://discord.gg/bU5ph8EX

He calls his UPS the "Pi Vault". And he sells his stuff mainly through Lectronz and Tindie.

Closed 2021-11-19.

Thread 11 (2024-10-07):

Strange behavior

suomi35, 2024-10-07:
I've built the circuit, flashed an ATTiny85, and connected everything (Raspberry Pi Zero 2 W + Geekworm 1.0).

I have a couple of issues:

1. I am able to power the system on via the button, but the shutdown behavior is not quite right. When I press the button to initiate shutdown the rPi does shutdown, but then gets powered back up after a period of time (a minute or so).
Is that the expected behavior? (I was expecting the rPi to remain powered off until I press the button again.)

2. I also observe that when I am running on battery alone, and the battery goes low, the rPi is shutdown correctly, but the ATTiny LED keeps flashing at once-per-second, 'never' tuning off. If I then plug USB power back into the geekworm, nothing changes; the rPi remains off and the LED continues to blink once-per-second. Pressing the ATTiny button has no effect, and I have to unplug both battery and USB from the geekworm in order to get the rPi to boot.

Here is my config file:
```
[attinydaemon]
button function = shutdown
ups configuration = 0x0
primed = 1
external voltage constant = 700
external voltage coefficient = 2000
sleeptime = 20
ups shutdown voltage = 3200
timeout = 120
pulse length = 200
pulse length on = 500
pulse length off = 4000
temperature coefficient = 1000
i2c address = 0x37
battery voltage constant = 0
restart voltage = 3900
warn voltage = 3400
temperature constant = -270
battery voltage coefficient = 1000
force shutdown = 0
switch recovery delay = 200
loglevel = ERROR
led off mode = 0
```

```
suomi35@test-pi:/opt/attiny_daemon $ sudo systemctl status attiny_daemon
● attiny_daemon.service - ATTiny UPS Daemon
     Loaded: loaded (/etc/systemd/system/attiny_daemon.service; enabled; vendor preset: enabled)
     Active: active (running) since Mon 2024-10-07 14:55:48 PDT; 21min ago
   Main PID: 340 (attiny_daemon.p)
      Tasks: 1 (limit: 191)
        CPU: 512ms
     CGroup: /system.slice/attiny_daemon.service
             └─340 /usr/bin/python3 -u /opt/attiny_daemon/attiny_daemon.py

Oct 07 14:55:48 test-pi systemd[1]: Started ATTiny UPS Daemon.
```

jbaumann, 2024-10-08:
When you set `primed` in the config file, the ATTiny tries to keep the RPi running as long as the battery voltage is high enough. So to have the button act as a On/Off button you first have to turn `primed` off.

Your second issue suggests that the voltage measurements might be off. You can check that using the script `ShowStateAndBattery.py` or `useATTiny.py` (which is more of a test program). You have to adjust the voltage calculation so that it is in the same ballpark as the actual voltage. You can do that with the battery voltage constant and coefficient(see Wiki).

suomi35, 2024-10-08:
@jbaumann thank you for the lightning fast response! 🤘
Setting `primed = 0` fixed the button issue immediately.

I will study the constant/coefficient section of the wiki and see where I need to move the voltage calculation.
(Also, I am currently monitoring the Vcc line from the Geekworm through the voltage divider to pin 2 on the ATTiny...maybe that is silly, given that it should always be 5v or nothing.)

Closed 2024-10-09.
