jbaumann/attiny_daemon/hardware/v1.8/PCB.pdf

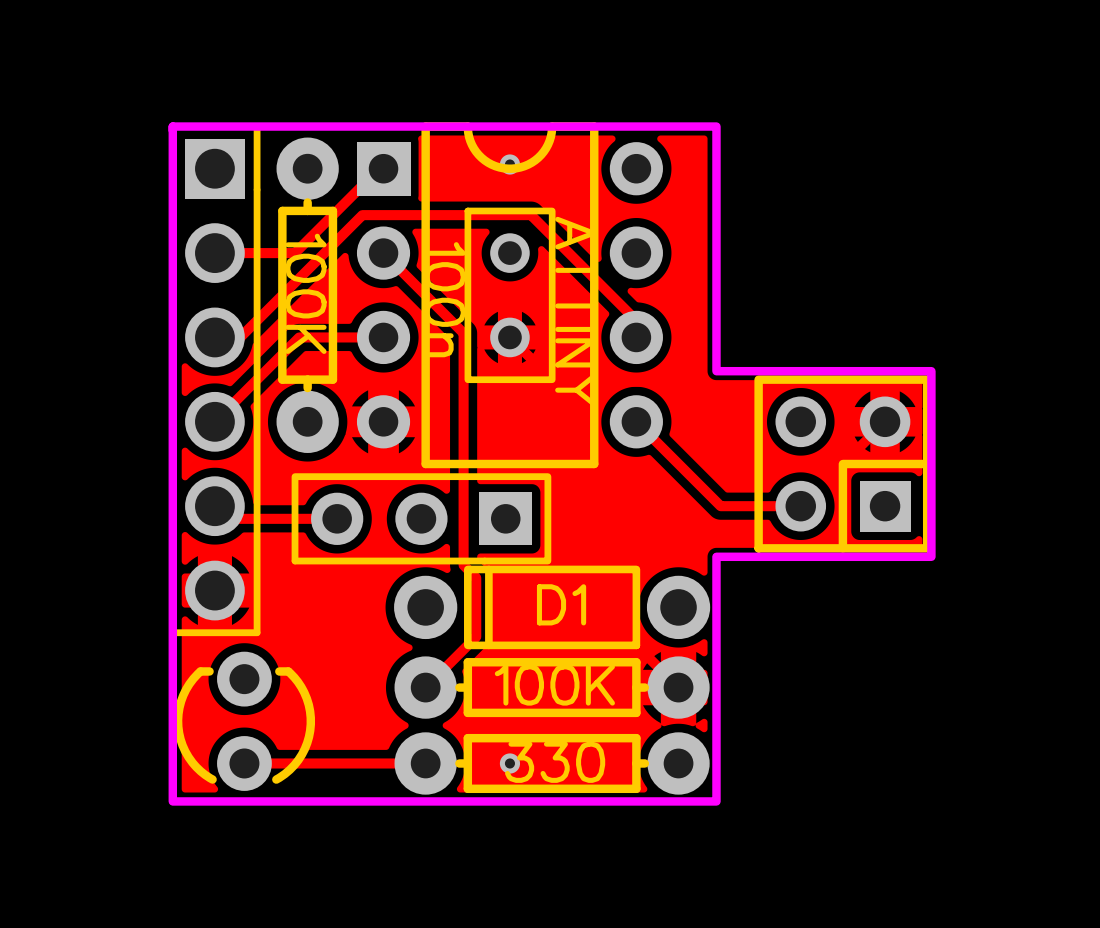
[picture p12: page 1]
