jbaumann/attiny_daemon/hardware/v1.8/Schematic_ATTinyDaemon.pdf

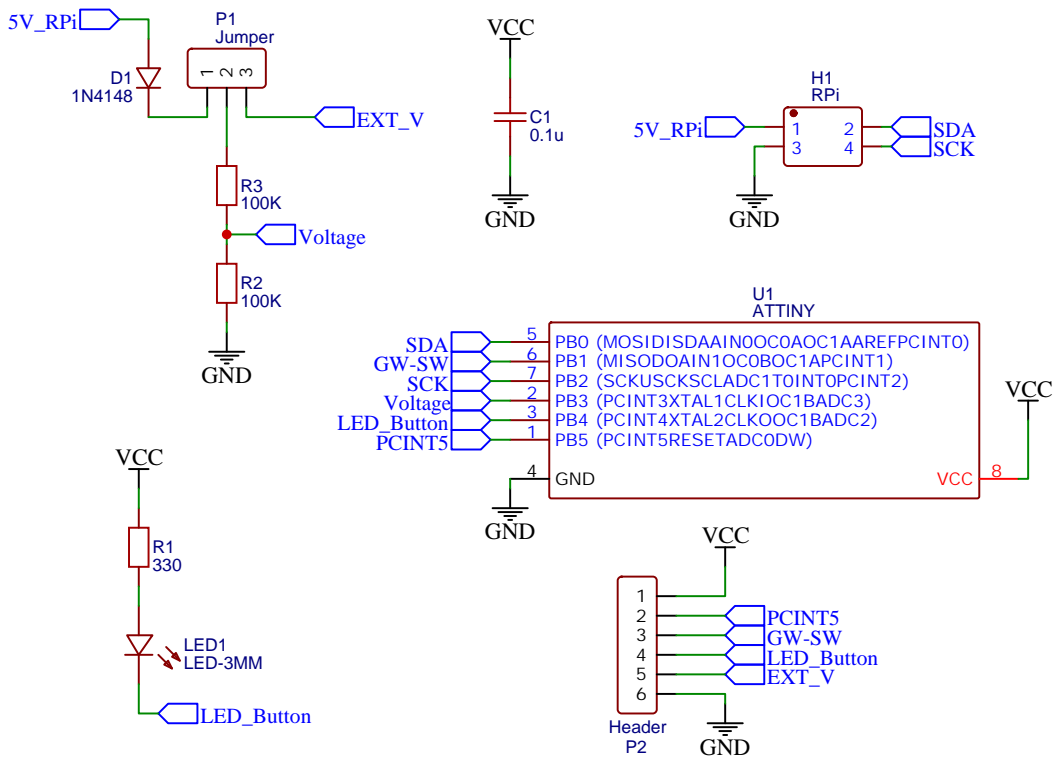
[picture p13: page 1]
