jbaumann/attiny_daemon/hardware/v1.8shim/PCB.pdf

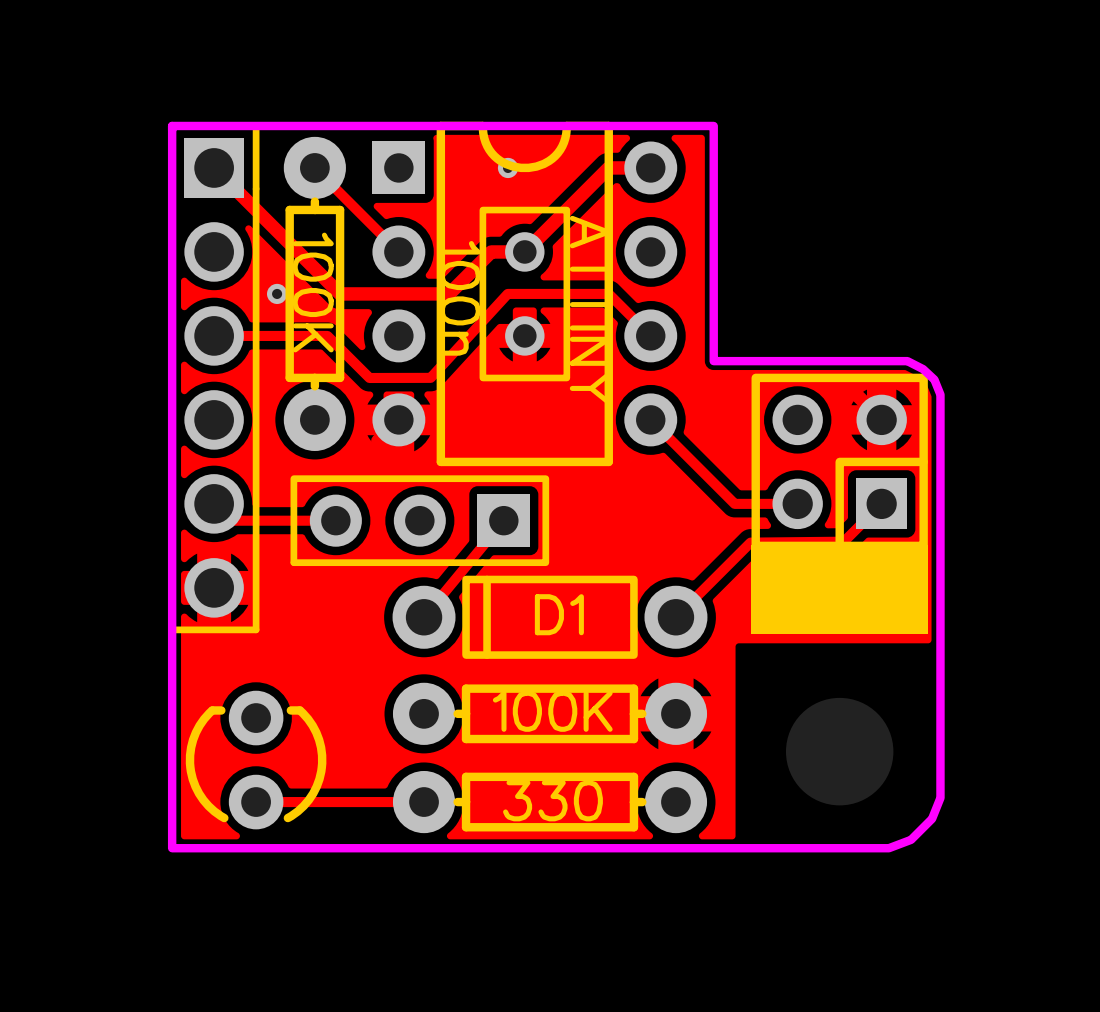
[picture p14: page 1]
