jbaumann/attiny_daemon/hardware/v1.7/PCB.pdf

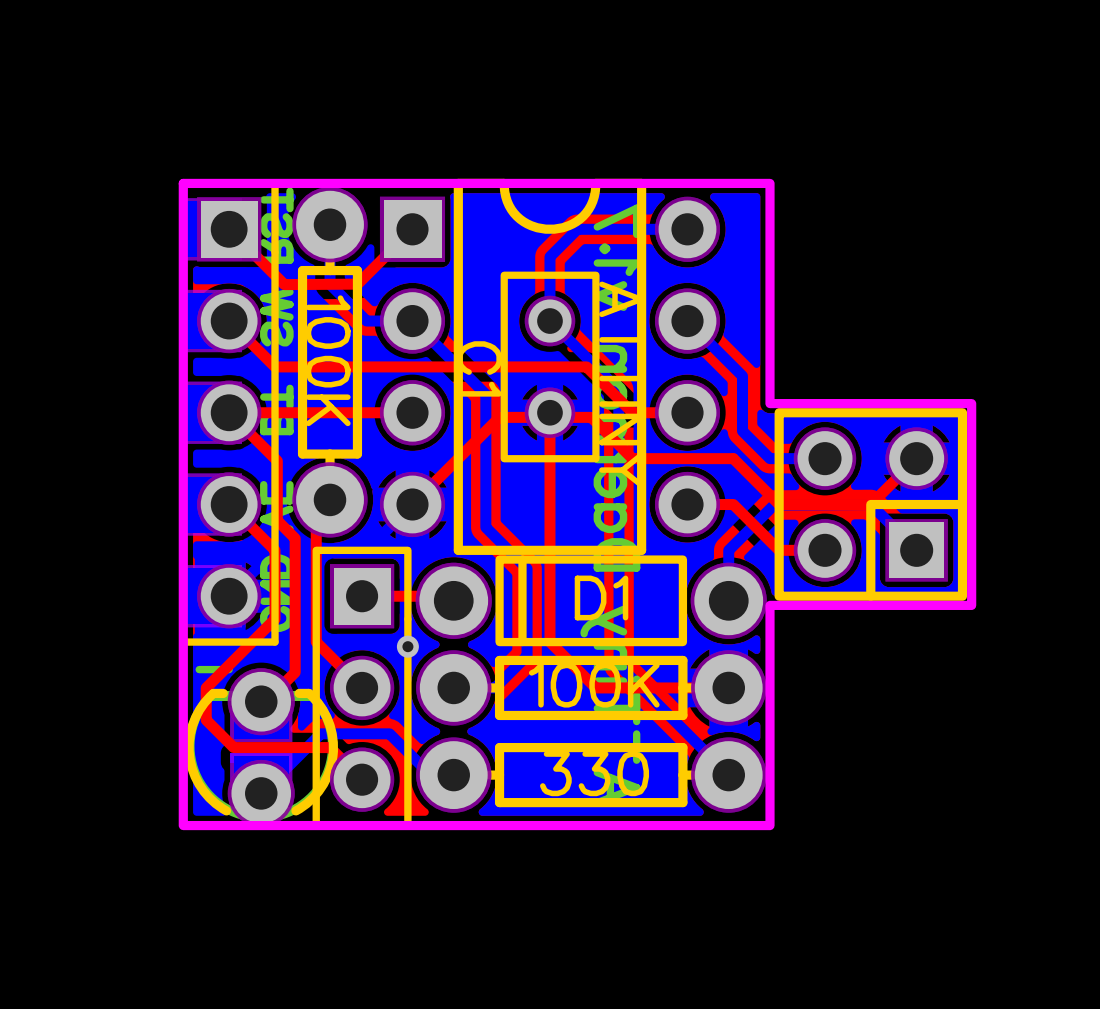
[picture p15: page 1]
