jbaumann/attiny_daemon/hardware/v1.7/Schematic.pdf

## VCC

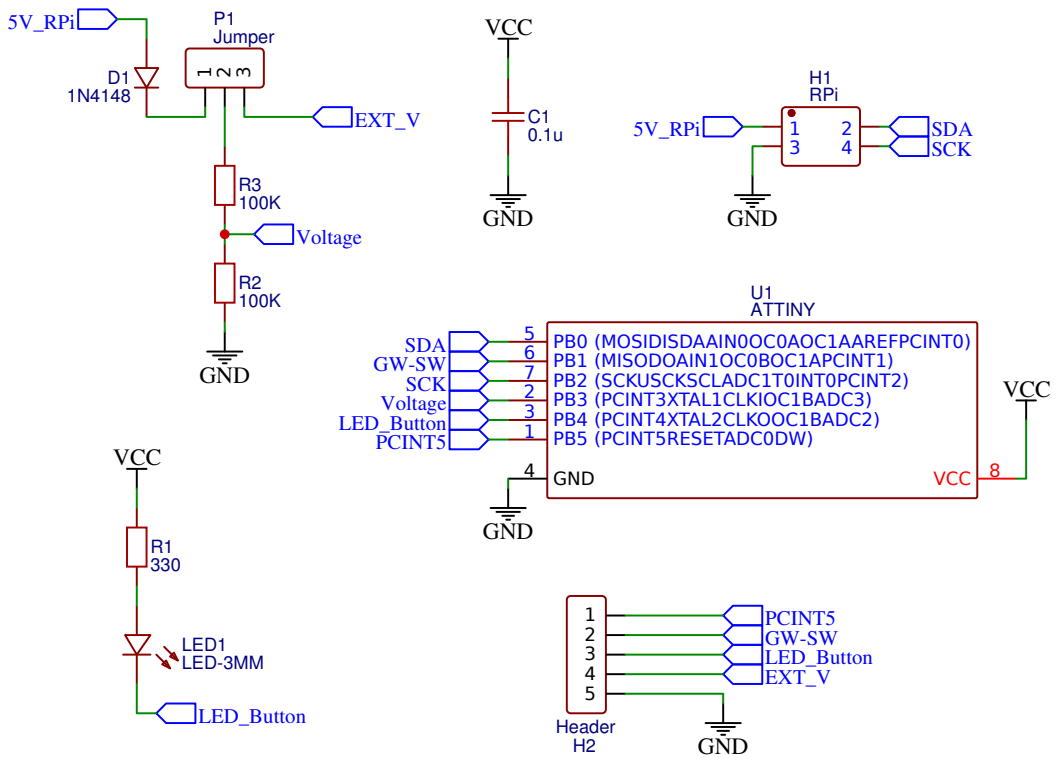
[picture p16: page 1]
