jbaumann/attiny_daemon/firmware/ATTinyDaemon/handleState.ino

/*
   The state variable encapsulates the all-over state of the system (ATTiny and RPi
   together).
   The possible states are:
    RUNNING_STATE       -  0 - the system is running normally
    UNCLEAR_STATE       -  1 - the system has been reset and is unsure about its state
    WARN_TO_RUNNING     -  2 - the system transitions from warn state to running state
    SHUTDOWN_TO_RUNNING -  4 - the system transitions from shutdown state to running state
    WARN_STATE          -  8 - the system is in the warn state
    WARN_TO_SHUTDOWN    - 16 - the system transitions from warn state to shutdown state
    SHUTDOWN_STATE      - 32 - the system is in the shutdown state

    They are ordered in a way that allows to later check for the severity of the state by
    e.g., "if(state <= WARN_STATE)"

    This function implements the state changes between these states, during the normal
    execution but in the case of a reset as well. For this we have to take into account that
    the only information we might have is the current voltage and we are in the RUNNING_STATE.
*/
void handle_state() {
  uint16_t seconds_safe;
  ATOMIC_BLOCK(ATOMIC_FORCEON) {
    seconds_safe = seconds;
  }
  // Turn the LED on
  if (state <= State::warn_state) {
    if (primed == 1 || (seconds_safe < timeout) ) {
      // start the regular blink if either primed is set or we are not yet in a timeout.
      ledOn_buttonOff();
    }
  }
#if defined SERIAL_DEBUG
  Serial.println(F("In handleState()"));
  Serial.print(F("Bat: "));
  Serial.print(bat_voltage);
  Serial.print(F("mV, S: "));
  Serial.print(uint8_t(state), HEX);
  Serial.print(F(", ss: "));
  Serial.println(should_shutdown, HEX);
#endif

  // change the state depending on the current battery voltage
  voltage_dependent_state_change();

  // If the button has been pressed or the bat_voltage is lower than the warn voltage
  // we blink the LED 5 times to signal that the RPi should shut down, if it has not
  // already signalled that it is doing so
  if (state <= State::warn_state) {
    // we first check whether the Raspberry is already in the shutdown process
    if (!(should_shutdown & Shutdown_Cause::rpi_initiated)) {
      if (should_shutdown > Shutdown_Cause::rpi_initiated && (seconds_safe < timeout)) {
        // RPi should take action, possibly shut down. Signal by blinking 5 times
        blink_led(3, BLINK_TIME);
      }
    }
  }

  act_on_state_change();

#if defined SERIAL_DEBUG
  Serial.println(F("After act_on_state_change()"));
  Serial.print(F("Bat: "));
  Serial.print(bat_voltage);
  Serial.print(F("mV, S: "));
  Serial.print(uint8_t(state), HEX);
  Serial.print(F(", ss: "));
  Serial.println(should_shutdown, HEX);
#endif

  // Turn LED off
  if (state <= State::warn_to_shutdown) {
    // allow the button functionality as long as possible and even if not primed
    ledOff_buttonOn();
  }
}


/*
   Act on the current state
*/
void act_on_state_change() {
  // This is placed before the general check of all stages as to
  // not duplicate the code of the shutdown_state
  if (state == State::warn_to_shutdown) {
    // immediately turn off the system if force_shutdown is set
    if (primed == 1) {
      if (force_shutdown != 0) {
        ups_off();
      }
    }
    state = State::shutdown_state;
  }

  if (state == State::shutdown_state) {
    ledOff_buttonOff();
  } else if (state == State::warn_state) {
    // The RPi has been warned using the should_shutdown variable
    // we simply let it shutdown even if it does not set SL_INITIATED

    reset_counter_Safe();
  } else if (state == State::shutdown_to_running) {
    // we have recovered from a shutdown and are now at a safe voltage
    if (primed == 1) {
      ups_on();
    }
    reset_counter_Safe();
    state = State::running_state;
    should_shutdown = Shutdown_Cause::none;
  } else if (state == State::warn_to_running) {
    // we have recovered from a warn state and are now at a safe voltage
    // we switch to State::running_state and let that state (below) handle
    // the restart
    state = State::running_state;
    should_shutdown = Shutdown_Cause::none;
  } else if (state == State::unclear_state) {
    // we do nothing and wait until either a timeout occurs, the voltage
    // drops to warn_voltage or is higher than restart_voltage (see handle_state())
  }

  if (state == State::running_state) {
    bool should_restart = false;
    bool reset_i2c_bus = false;

    if (vext_off_is_shutdown) {
      should_restart = ext_voltage < MIN_POWER_LEVEL;
    } else {
      ATOMIC_BLOCK(ATOMIC_FORCEON) {
        should_restart = seconds > timeout;
        reset_i2c_bus = seconds > (timeout / 2);
      }
    }

    // reset bus until we get connection again or until time is out
    if (reset_i2c_bus) {
      init_I2C();
    }
    if (should_restart) {
      if (primed > 0
          || (primed == 0 && (should_shutdown && static_cast<uint8_t>(Shutdown_Cause::button))) ) {
        // RPi has not accessed the I2C interface for more than timeout seconds.
        if(tried_reset) {
          // we already tried the reset. Blink 5 times to signal that.
          blink_led(5, BLINK_TIME / 2);
        } else {
          tried_reset = true;
          // We restart it. Signal restart by blinking ten times
          blink_led(10, BLINK_TIME / 2);
          restart_raspberry();
        }

        // Primed has been set by the button press, we use the restart time
        // for debouncing
        should_shutdown &= ~Shutdown_Cause::button;

        reset_counter_Safe();
      }
    }
  }
}


/*
   Change the state dependent on the freshly read battery voltage
*/
void voltage_dependent_state_change() {
  uint16_t ups_shutdown_voltage_safe, warn_voltage_safe, restart_voltage_safe;

  read_voltages();

  ATOMIC_BLOCK(ATOMIC_FORCEON) {
    ups_shutdown_voltage_safe = ups_shutdown_voltage;
    warn_voltage_safe = warn_voltage;
    restart_voltage_safe = restart_voltage;
  }

  if (bat_voltage <= ups_shutdown_voltage_safe) {
    if (state < State::warn_to_shutdown) {
      state = State::warn_to_shutdown;
    }
  } else if (bat_voltage <= warn_voltage_safe) {
    if (state < State::warn_state) {
      state = State::warn_state;
      should_shutdown |= Shutdown_Cause::bat_voltage;
    }
  } else if (bat_voltage <= restart_voltage_safe) {
    uint16_t seconds_safe;
    ATOMIC_BLOCK(ATOMIC_FORCEON) {
      seconds_safe = seconds;
    }

    if (state == State::unclear_state && seconds_safe > timeout) {
      // the RPi is not running, even after the timeout, so we assume that it
      // shut down, this means we come from a WARN_STATE or SHUTDOWN_STATE
      state = State::warn_state;
    }
  } else { // we are at a safe voltage

    switch (state) {
      case State::shutdown_state:
        state = State::shutdown_to_running;
        break;
      case State::warn_to_shutdown:
        state = State::shutdown_to_running;
        break;
      case State::warn_state:
        state = State::warn_to_running;
        break;
      case State::unclear_state:
        state = State::running_state;
        break;
      // in the following cases nothing needs to be done
      case State::shutdown_to_running:
        break;
      case State::warn_to_running:
        break;
      case State::running_state:
        break;
     }
  }
}

/*
   When we get an I2C communication then this might change our state (because now we
   know the RPi is alive). Called only during an interrupt.
*/
void i2c_triggered_state_change() {
  // If we are in an unclear state, then a communication from the RPi moves us to running state
  if (state == State::unclear_state) {
    state = State::running_state;
  }
  tried_reset = false;
}
