jbaumann/attiny_daemon/firmware/ATTinyDaemon/handleWatchdog.ino

/*
 * The ATTiny datasheet I'm referencing is the ATTiny25/45/85 datasheet provided by Microchip. 
 * Pages and Chapter numbers are for the revision Rev. 2586Q-08/13.
 */

/*
 * taken from http://www.gammon.com.au/power
 * We use the watchdog to wake us from deep sleep. The length of the
 * deep sleep depends on the current battery voltage. If above 
 * warn_voltage, we wake every second, if between shutdown_voltage and
 * warn_voltage, we wake very 2 seconds, and if we are below shutdown_voltage
 * we only wake every 8 seconds. Our seconds counter is changed accordingly.
 */
void reset_watchdog () {
  uint8_t wd_value;

  uint16_t bat_voltage_safe, ups_shutdown_voltage_safe, warn_voltage_safe;
  ATOMIC_BLOCK(ATOMIC_FORCEON) {
    bat_voltage_safe = bat_voltage;
    ups_shutdown_voltage_safe = ups_shutdown_voltage;
    warn_voltage_safe = warn_voltage;
  }

  if (bat_voltage_safe <= ups_shutdown_voltage_safe) {
    // either startup or low power (includes bat_voltage == 0)
    // If we are starting then this gives us enough time to
    // initialize everything without any problems    
    wd_value = bit (WDIE) | bit (WDP3) | bit (WDP0);                 // set WDIE, and 8 seconds delay

    ATOMIC_BLOCK(ATOMIC_FORCEON) {
      seconds += 8;
    }
  } else if (bat_voltage_safe <= warn_voltage_safe) {
    // warn_voltage, we reduce signalling to every 2 seconds
    wd_value = bit (WDIE) | bit (WDP2) | bit (WDP1) | bit (WDP0);    // set WDIE, and 2 second delay

    ATOMIC_BLOCK(ATOMIC_FORCEON) {
      seconds += 2;
    }
  } else {
    // everything ok, we signal every second
    wd_value = bit (WDIE) | bit (WDP2) | bit (WDP1);                 // set WDIE, and 1 second delay

    ATOMIC_BLOCK(ATOMIC_FORCEON) {
      seconds += 1;
    }
  }

  // clear various "reset" flags
  MCUSR = 0;
  // allow changes, disable reset, clear existing interrupt, data sheet ch. 8.5.2, p.46ff
  WDTCR = bit (WDCE) | bit (WDE) | bit (WDIF);
  // data change, Ch. 8.4.1.2, the new timeout value has to be written within the next
  // 4 cycles. Thus we first determine the correct value (above) and then write it at once. 
  WDTCR = wd_value;

  wdt_reset();
}

/*
 * Here we disable the watchdog. It is not enough to call wdt_disable(), MCUSR has to be set to 0 as well
 * on the ATTiny. Although this is not pointed out explicitly in the datasheet on p. 42 where
 * disabling the watchdog is explained, on p. 44 there is an example C code that does exactly that, and
 * additionally on p. 46 when explaining WDE it is mentioned in passing. 
 */
void disable_watchdog() {
  
  MCUSR = 0;
  wdt_disable();  // disable watchdog
}

/*
 * This ISR will be called when the watchdog wakes up the system.
 */
ISR (WDT_vect) {
  disable_watchdog();
}
