jbaumann/attiny_daemon/(commit log)

2019-07-24 added picture of the actual PCB
2019-07-25 Added a photo of the populated pcb
2019-08-06 Added explicit state to firmware, semantic versioning, better reaction to reset, check for version compatibility between daemon and firmware
    [attiny_daemon.cfg]
2019-09-03 Added/Changed Changed Communication protocol to use an 8 bit CRC. This is a major and breaking change and thus the major version number is bumped. Additionally, the timeout has been shortened to 400m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
    [attiny_daemon.cfg]
2019-09-04 New/Added The python daemon now consists of two files, the main daemon atttiny_daemon.py and the module attiny_i2c.py that contains everything related to communication with the ATTinyDaemon. An examp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
    Fixed Bugs
    Register numbers are now printed in hex.
    [attiny_daemon.py, attiny_i2c.py, useATTiny.py]
2020-01-06 Add files via upload
    BOM for v1.8
    [BOM_ATTinyDaemon_1.8.csv]
2020-01-06 Add files via upload
    Assembly Pictures
2020-01-23 Added LCSC part numbers
    [BOM_ATTinyDaemon_1.8.csv]
2020-02-17 fixes crashes due to NameError: name '_num_retries' is not defined
    [attiny_i2c.py]
2020-03-23 Added reset configuration that allows different types of reset process
    [ATTinyDaemon.h, ATTinyDaemon.ino, handleI2C.ino, handleIO.ino, handleState.ino]
2020-03-26 Added functionality to read and write the reset configuration from the attiny_daemon. The corresponding option in the config file is 'reset configuration'. Bumped the minor version of both firmware a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
    [attiny_daemon.cfg]
2020-03-29 Removed all support for the ATTiny45. Cleaned up code to mainly use switch-case-statements instead of the very long if-else if-chains. Added full support for configurations that need a switch to be p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
    [attiny_daemon.cfg]
2020-04-01 Added Refactored the interaction with the UPS and added the functionality to turn the UPS off for the switched mode as well as for the voltage level mode. Fixed Bugs Fixed regression that reintroduce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
    [ATTinyDaemon.h, ATTinyDaemon.ino, attiny_i2c.py, handleIO.ino]
2020-04-07 Another regression leading to again having the problem in attiny_i2c.py
    [attiny_i2c.py]
2020-04-12 Changed default value for sw recovery delay to 1000. Added sleep_bod_disable() to going to sleep, so we can use the BOD fuses that guarantee that the ATTiny is kept in RESET when the power goes below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
    [attiny_daemon.cfg]
2020-04-13 New/Added Added the ability to read the fuse values from the ATTiny. Remove the in-band signalling of errors.
    [attiny_daemon.py, attiny_i2c.py, readFuses.py, useATTiny.py]
2020-04-13 Check processor frequency, change if possible to the right value, go into failure mode if not possible signalling SOS. Provide reading the fuse values over I2C.
    [ATTinyDaemon.h, ATTinyDaemon.ino, handleI2C.ino]
2020-04-14 Added get_internal_state() to read the current state of the ATTiny state machine
2020-04-18 Changed the levels in showStateAndBattery.py to reflect the new naming. Fixed a bug in attiny_daemon.py leading to shutdown if ATTiny_Daemon not reachable. This was introduced by changing the in-band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
    [attiny_daemon.py, showStateAndBattery.py]
2020-04-18 Cleaned up #define statements, introduced enums instead. Added LED_Off_mode. Separated eeprom code into a file of its own.
2020-04-18 Added LED_Off_Mode.
    [attiny_daemon.cfg]
2020-04-19 State and EEPROM_Address fully converted to Enums. Fixed bug that stored bat_v coefficient and constant into the ext_v fields.
    [ATTinyDaemon.h, ATTinyDaemon.ino, handleEEPROM.ino, handleI2C.ino, handleIO.ino, handleState.ino, handleVoltages.ino]
2020-04-19 Fully switched to enum types.
2020-04-25 Changed the order of instructions in ledOff_buttonOn(). This should reduce the power consumption still further.
2020-04-26 Moved the delay that lets the ADC settle outside of the measurement loop, since the ADC configuration does not change inside the loop. This reduces the non-sleep time by 8ms ((NUM_MEASUREMENTS-1)*2).
2020-04-26 Refactored setup() and main loop(). Moved EEPROM and I2C init code to the respective files. Move the remaining state handling to handle_state(). Moved the code handling the power down sleep to handle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
2020-04-26 Optimized the handling of the ADC to reduce time spent running. Instead of waiting 2ms for each of the sources we now only wait 2ms for stabilizing the internal voltage reference. To get a measure of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
2020-04-30 Refactored handleCRC to get rid of the global variable for calculating the CRC. Refactored I2C code. Moved all I2C code to handleI2C.ino (new function i2c_triggered_state_change()). Reset bat_voltage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
    [ATTinyDaemon.ino, handleCRC.ino, handleI2C.ino, handleState.ino]
2020-05-02 changed check for fuse settings to ignore the startup time settings. All of them are ok when BOD is set.
2020-05-03 Modified the ATTiny Communication class to wait a bit longer when writing to the ATTiny. On the ATTiny write operations include writing to the EEPROM which needs more time. Added a new script attiny_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
2020-05-08 Local copy of Brousant's schematics of the Geekworm UPS1
2020-05-10 Added reporting of the current uptime to the json message. Allow additional info to be set to None to remove it.
2020-06-04 Added command UPTIME to I2C communication. Changed default timeout to 120s.
    [attiny_daemon.cfg]
2020-06-04 Added I2C command UPTIME to return the uptime (this is not real milliseconds because the deep sleep turns off all millisecond functionality). Fixed bug: The stored value for force_shutdown wasn't rea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
    [ATTinyDaemon.h, ATTinyDaemon.ino, handleEEPROM.ino, handleI2C.ino]
2020-06-06 Fixed Bug: The change introduced in v2.9.15 to further reduce power consumption introduces spurious interrupts that are recognized as false button presses. This update rolls back that change.
    [ATTinyDaemon.ino, handleIO.ino]
2020-06-09 Added an I2C command to read the last reset cause (the register MCUSR). Fixed a bug that led to resetting the ATTiny after some time. The underlying cause was that the callback that actually did the 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
    [ATTinyDaemon.h, ATTinyDaemon.ino, handleI2C.ino, handleWatchdog.ino]
2020-06-09 Corrected the register number for the mcusr register.
    [ATTinyDaemon.h, ATTinyDaemon.ino]
2020-06-09 Added an I2C command to read the last reset cause (the register MCUSR).
    [attiny_daemon.py, attiny_i2c.py]
2020-07-05 Moved the EEPROM update from the I2C receive_event() function to the main loop to reduce the time spent in the interrupt. This should further reduce communication errors.
    [ATTinyDaemon.ino, handleEEPROM.ino, handleI2C.ino, handleIO.ino, handleWatchdog.ino]
2020-07-17 Changed all variables that can be accessed via interrupt (i.e., which are I2C registers) to volatile. Only variables that remain unchanged after setup() are exempt from this. Moved all eeprom writes 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
    [ATTinyDaemon.h, ATTinyDaemon.ino, handleCRC.ino, handleEEPROM.ino, handleI2C.ino, handleIO.ino, handleState.ino, handleVoltages.ino]
2020-07-18 Changed to my own version of USIWire until my pull request is accepted. This allows us to turn off the watchdog as soon as the interrupt is called.
2020-08-05 Add new register vext_off_is_shutdown. When set, the ATTiny checks Vext instead of the number of seconds since the last access to ensure that the RPi is still running. Add symbolic values for the Res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
    [ATTinyDaemon.h, ATTinyDaemon.ino, handleEEPROM.ino, handleI2C.ino, handleIO.ino, handleState.ino]
2020-08-05 Added config option "i2c bus" allowing to choose the bus for the I2C communication. This is needed if a bit-banged alternative implementation for the I2C bus is used. Added config option "vext off is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
    [attiny_daemon.py, attiny_i2c.py]
2020-09-05 Fixed bug that, after a state change to shutdown allowed a state change directly back to warn, leading to possible oscillations between the states.
    [handleState.ino]
2020-09-06 Fixed bug that led to repeated calls to shutting down the UPS, effectively turning it on again in some situations.
    [handleState.ino]
2020-09-09 Changed function act_on_state_change() so that the correct state is reflected even if primed is not set. This makes the function of the state machine clearer (but needs a bit more flash).
    [handleState.ino]
2020-09-13 Added two new options "pulse length on" and "pulse length on" for those UPSs that need pulses of different length to turn on and off. Fixed a small typo that would have led to an exception if the con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
    [attiny_daemon.cfg]
2020-09-13 Added two new registers, "pulse_length_on" and "pulse_length_off" for those UPSs that need pulses of different length to turn on and off, respectively. If either is set then it overrules the value of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
    [ATTinyDaemon.h, ATTinyDaemon.ino, handleEEPROM.ino, handleI2C.ino, handleIO.ino]
2020-09-19 Refactored the blinkenlight functionality. this was overdue after the refactoring of the state machine and gets rid of some edge cases in which the LED continuted blinking.
2020-09-19 Refactoring to communicate the intent of some configuration options clearer. - "shutdown voltage" is now "ups shutdown voltage" - "reset configuration" is now "ups configuration" - "reset pulse lengt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
    [attiny_daemon.cfg]
2020-09-19 Refactoring to communicate the intent of some configuration options clearer. - "shutdown voltage" is now "ups shutdown voltage" - "reset configuration" is now "ups configuration" - "reset pulse lengt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
    In voltage_dependent_state_change() some values were not saved from change during an interrupt. Fixed.
    [ATTinyDaemon.h, ATTinyDaemon.ino, handleEEPROM.ino, handleI2C.ino, handleIO.ino, handleState.ino, handleWatchdog.ino]
2020-09-24 Changed the meaning of config option led_off_mode. Now takes an integer that decides in which state to signal by comparing the number to the current state. 0 is always, 1 is in any state but running,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
2020-09-26 Changed the meaning and type of led_off_mode. It is now an integer. When 0, it always blinks, larger than 0, blinks only in warn state, larger than 8 (numerical value of the warn state), blinks never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
    Changed the meaning of the 4 high bits of the ups configuration. Bits 4-5 contain the value of pulse repeats for turning the ups off, bits 6-7 the value of pulse repeats for turning the ups on. The delay between the repeated pulses is a switch_recovery_delay / 4.
2020-09-26 Changed the meaning and type of led_off_mode. It is now an integer. When 0, it always blinks, larger than 0, blinks only in warn state, larger than 8 (numerical value of the warn state), blinks never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
    [attiny_daemon.cfg]
2020-09-26 changed the constant and the coefficient for the evternal voltag to more conservative values
    [attiny_daemon.cfg]
2020-10-07 Added atomic blocks to all I/O operations to guarantee that switching the pins is not interrupted by anything. Corrected the switch pin operation. Until now it was driven high by the input pullup. No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
    [handleIO.ino]
2020-10-13 Changed the low voltage level to 3.7V (3.63+0.07V, the spec of the APX803 power monitor chip).
2020-10-19 changed the comment to correctly describe current behaviour
    [handleIO.ino]
2020-11-07 Remove USIWire.h in favor of the Wire-implementation provided by ATTinyCore. It now works with the code and needs less memory.
2020-11-07 incremented patch level to reflect the changed Wire/I2C implementation
2020-11-07 Added serial debug ability. By #def'ing SERIAL_DEBUG (see ATTiny_Daemon.h) the button and normal LED functionality is turned off and the pin is instead used as a serial debug line with 115200 baud. T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
2020-11-12 The ATTiny85 turns off the pull-up on deep sleep and furthermore pulls input pins without interrupts to ground. This could lead to problems with UPSs. The code is changed so that the high state is no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
    [ATTinyDaemon.ino, handleIO.ino]
2020-11-16 Changed all comparisons of primed to ensure that it compares against the value 1. This ensures that even if values are read from the eeprom that are totally wrong, that the ATTiny_Daemon is not prime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
    [ATTinyDaemon.ino, handleEEPROM.ino, handleState.ino]
2021-01-24 Changed const variables to static const
    Introduced a fast_exit mode to the daemon to support a faster restart
    Added a call to Wire.end() to the initialization of the I2C bus. This allows to re-init the bus at any time with the same call.
    After half of the timeout the ATTiny starts to re-initialize the I2C bus every second as long as there is no new communication with the RPi.
    The combination of measures should allow for a faster recovery if the I2C bus is blocked
2021-02-17 Turning on the UPS now triggers reinitialization of the I2C implementation. This ensures that on restarting the RPi the I2C bus is clean.
2021-04-23 Fixed a small bug with the user button when pressed while the RPi is shut down. Now should restart always as soon as the timeout period has elapsed.
    [ATTinyDaemon.ino, handleState.ino]
2021-04-24 Changed signalling the button press using primed to checking the should_shutdown value. This removes an edge case that in theory would allow to write primed=2 to the EEPROM
2021-11-22 Added a message in case the sudo command failed.
    [attiny_daemon.py]
2022-03-13 Changed behavior to try and reset the RPi only once instead of infinitely.
    [ATTinyDaemon.ino, handleCRC.ino, handleState.ino]
2022-03-15 fixed the wrong placement of resetting the variable tried_reset
    [ATTinyDaemon.h, ATTinyDaemon.ino, handleState.ino]
2022-11-06 Changed the source code so that it complies with the new compiler of Arduino IDE 2.0 and added pragmas where this is not possible. The code now compiles without warnings even on the highest "Compiler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
